team-impulse/Biscay_Blueeye/base_gui/basemap/map.png

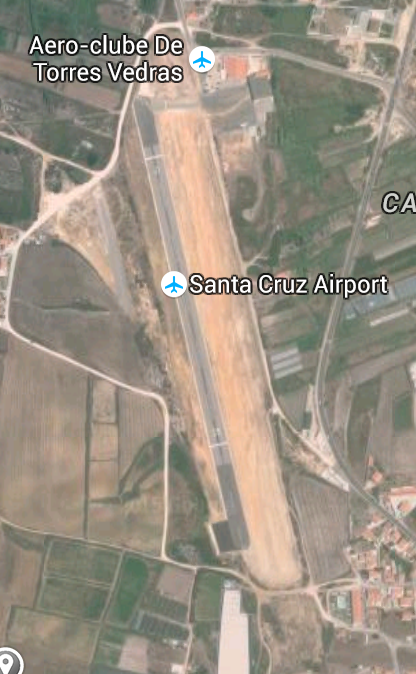
base_gui/basemap/map.png
