team-impulse/Biscay_Blueeye/base_gui/schema.rtf

CRC check (signal OK?) “True” or “False” (NO FURTHER DATA IF “False”)
RSSI (Received radio strength) (dB)
SNR (received radio signal-to-noise ratio) (dBm)
Air pressure (hPa)
External temperature (degC)
Internal (on-board) temperature (degC)
Relative Humidity (%)
Latitude (decimal degrees)
Longitude (decimal degrees)
HDOP (GPS precision, m)
Course (decimal degrees - please don’t convert to radians on the graph! It doesn’t make sense)
