team-impulse/Biscay_Blueeye/hardware/sensor-afe/sipm.kicad_pcb

## KiCad design hardware/sensor-afe/sipm.kicad_pcb (2015-10-05)

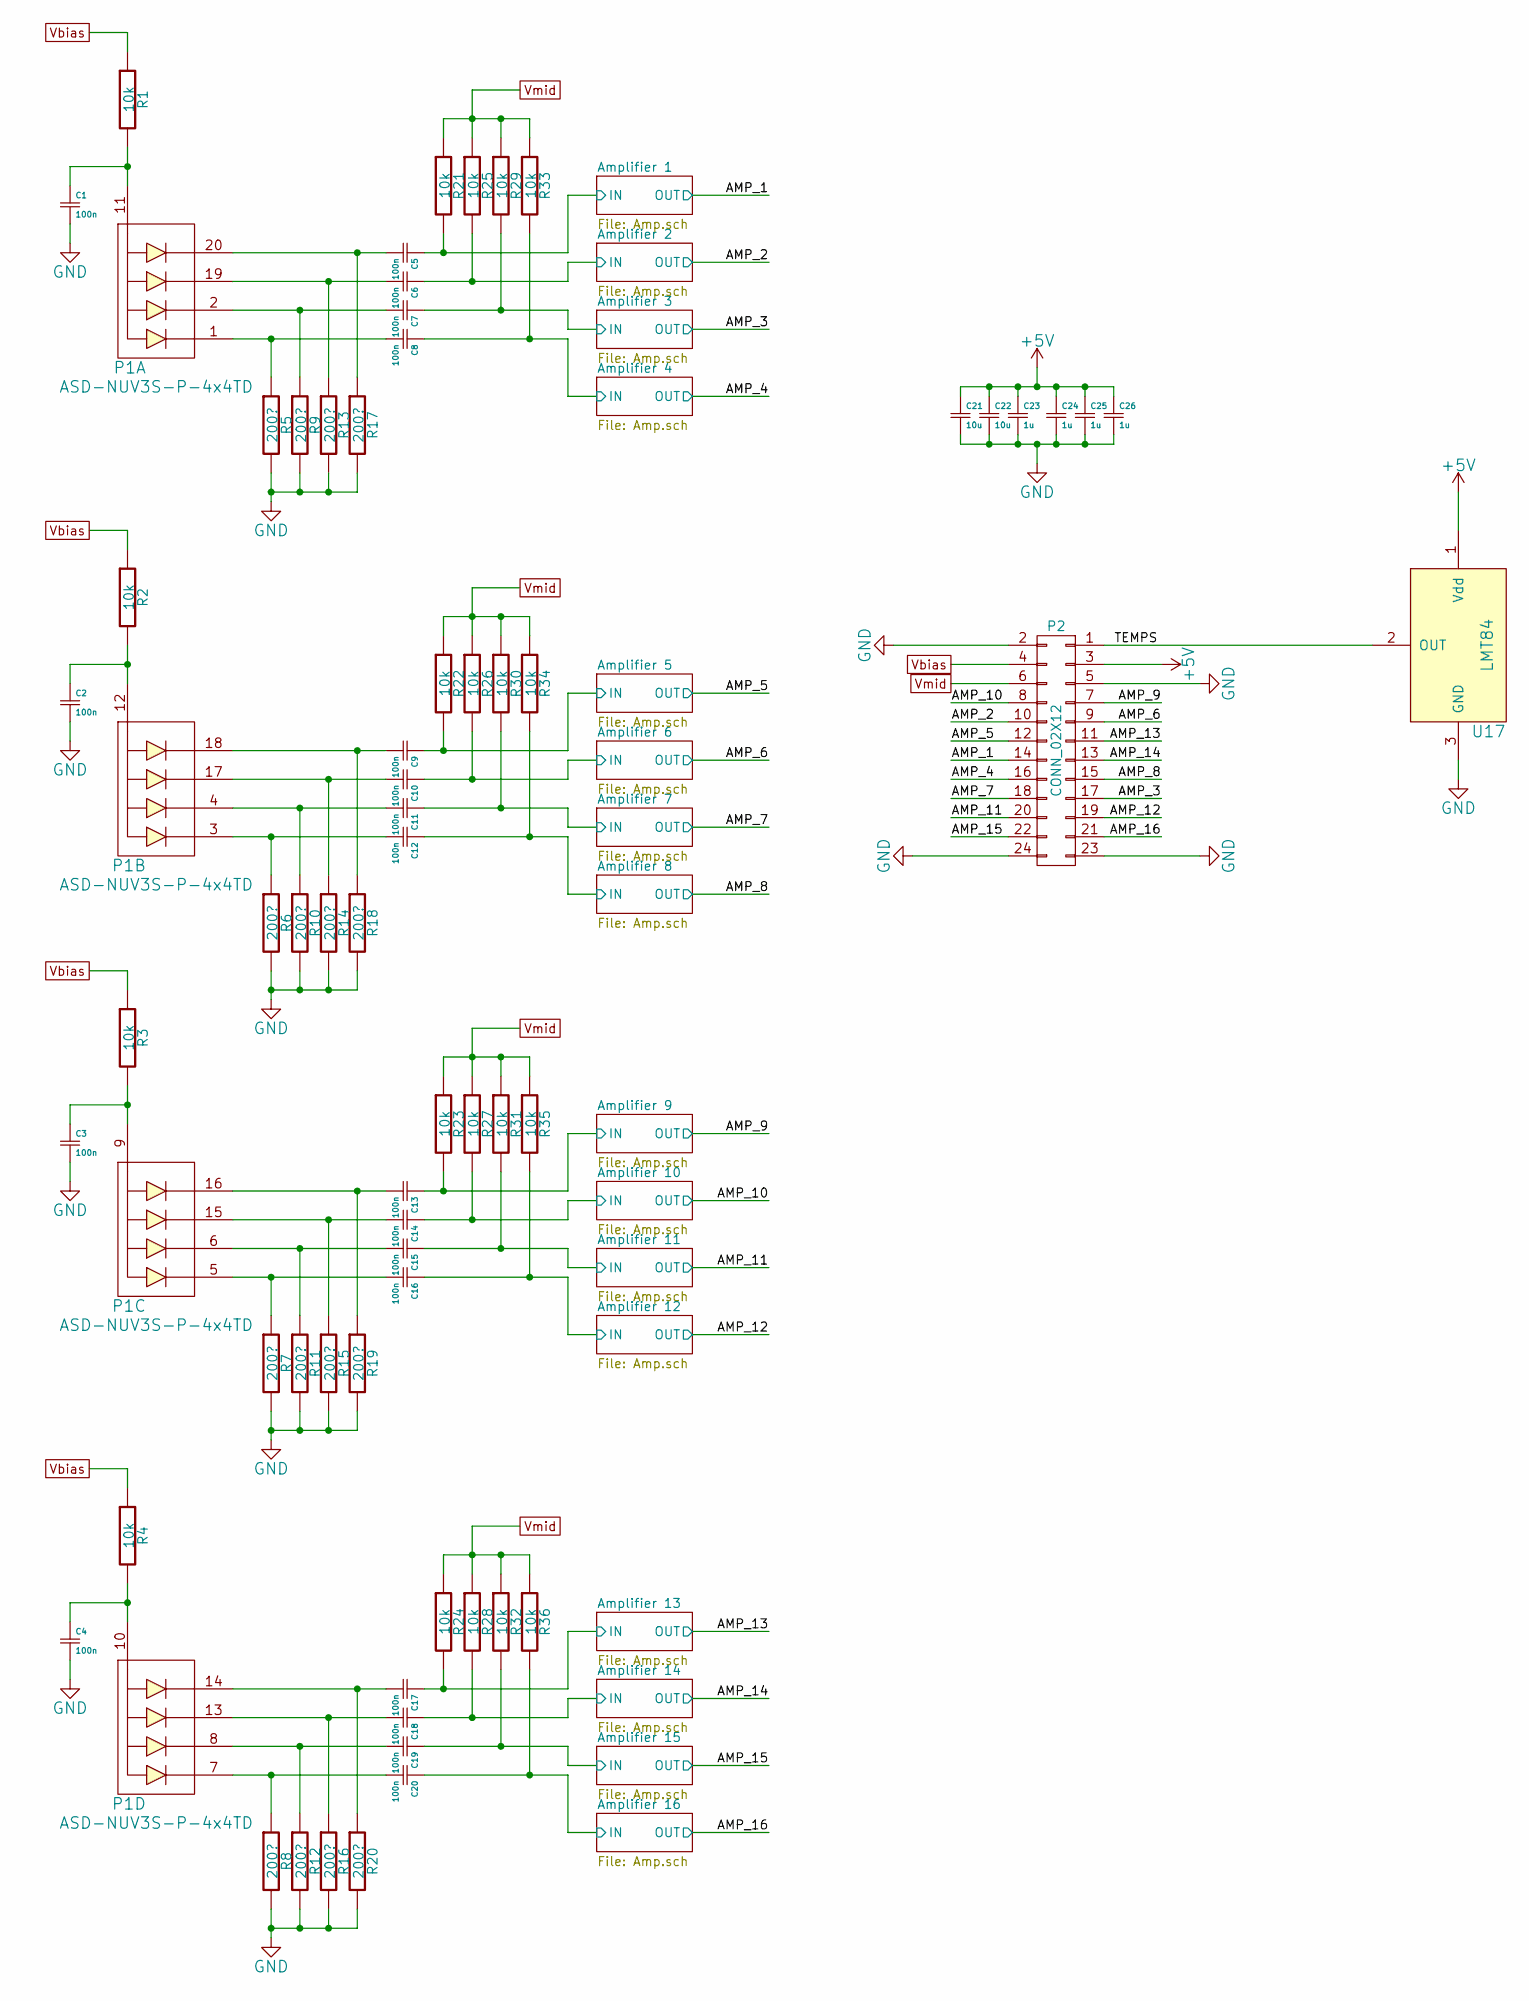
[picture p2: schematic sipm.sch]

Parts:
C1, C2, C3, C4, C5, C6, C7, C8, C9, C10, C11, C12, C13, C14, C15, C16, C17, C18, C19, C20: 100n
C21, C22: 10u
C23, C24, C25, C26: 1u
P1: ASD-NUV3S-P-4x4TD
P2: CONN_02X12
R1, R2, R3, R4, R21, R22, R23, R24, R25, R26, R27, R28, R29, R30, R31, R32, R33, R34, R35, R36: 10k
R5, R6, R7, R8, R9, R10, R11, R12, R13, R14, R15, R16, R17, R18, R19, R20: 200?
U17: LMT84

Connections:
+5V: C21.1, C22.1, C23.1, C24.1, C25.1, C26.1, P2.3, U17.1 (Vdd); also elsewhere on the board
/Amplifier 1/IN: C5.1, R21.2; also elsewhere on the board
/Amplifier 1/OUT: P2.14; also elsewhere on the board
/Amplifier 2/IN: C6.1, R25.2; also elsewhere on the board
/Amplifier 2/OUT: P2.10; also elsewhere on the board
/Amplifier 3/IN: C7.1, R29.2; also elsewhere on the board
/Amplifier 3/OUT: P2.17; also elsewhere on the board
/Amplifier 4/IN: C8.1, R33.2; also elsewhere on the board
/Amplifier 4/OUT: P2.16; also elsewhere on the board
/Amplifier 5/IN: C9.1, R22.2; also elsewhere on the board
/Amplifier 5/OUT: P2.12; also elsewhere on the board
/Amplifier 6/IN: C10.1, R26.2; also elsewhere on the board
/Amplifier 6/OUT: P2.9; also elsewhere on the board
/Amplifier 7/IN: C11.1, R30.2; also elsewhere on the board
/Amplifier 7/OUT: P2.18; also elsewhere on the board
/Amplifier 8/IN: C12.1, R34.2; also elsewhere on the board
/Amplifier 8/OUT: P2.15; also elsewhere on the board
/Amplifier 9/IN: C13.1, R23.2; also elsewhere on the board
/Amplifier 9/OUT: P2.7; also elsewhere on the board
/Amplifier 10/IN: C14.1, R27.2; also elsewhere on the board
/Amplifier 10/OUT: P2.8; also elsewhere on the board
/Amplifier 11/IN: C15.1, R31.2; also elsewhere on the board
/Amplifier 11/OUT: P2.20; also elsewhere on the board
/Amplifier 12/IN: C16.1, R35.2; also elsewhere on the board
/Amplifier 12/OUT: P2.19; also elsewhere on the board
/Amplifier 13/IN: C17.1, R24.2; also elsewhere on the board
/Amplifier 13/OUT: P2.11; also elsewhere on the board
/Amplifier 14/IN: C18.1, R28.2; also elsewhere on the board
/Amplifier 14/OUT: P2.13; also elsewhere on the board
/Amplifier 15/IN: C19.1, R32.2; also elsewhere on the board
/Amplifier 15/OUT: P2.22; also elsewhere on the board
/Amplifier 16/IN: C20.1, R36.2; also elsewhere on the board
/Amplifier 16/OUT: P2.21; also elsewhere on the board
/TEMPS: P2.1, U17.2 (OUT)
GND: C1.2, C2.2, C3.2, C4.2, C21.2, C22.2, C23.2, C24.2, C25.2, C26.2, P2.2, P2.5, P2.23, P2.24, R5.2, R6.2, R7.2, R8.2, R9.2, R10.2, R11.2, R12.2, R13.2, R14.2, R15.2, R16.2, R17.2, R18.2, R19.2, R20.2, U17.3 (GND); also elsewhere on the board
unnamed: C1.1, P1.11 (A1), R1.2
unnamed: C2.1, P1.12 (A2), R2.2
unnamed: C3.1, P1.9 (A3), R3.2
unnamed: C4.1, P1.10 (A4), R4.2
unnamed: C5.2, P1.20 (K1), R17.1
unnamed: C6.2, P1.19 (K2), R13.1
unnamed: C7.2, P1.2 (K3), R9.1
unnamed: C8.2, P1.1 (K4), R5.1
unnamed: C9.2, P1.18 (K5), R18.1
unnamed: C10.2, P1.17 (K6), R14.1
unnamed: C11.2, P1.4 (K7), R10.1
unnamed: C12.2, P1.3 (K8), R6.1
unnamed: C13.2, P1.16 (K9), R19.1
unnamed: C14.2, P1.15 (K10), R15.1
unnamed: C15.2, P1.6 (K11), R11.1
unnamed: C16.2, P1.5 (K12), R7.1
unnamed: C17.2, P1.14 (K13), R20.1
unnamed: C18.2, P1.13 (K14), R16.1
unnamed: C19.2, P1.8 (K15), R12.1
unnamed: C20.2, P1.7 (K16), R8.1
Vbias: P2.4, R1.1, R2.1, R3.1, R4.1
Vmid: P2.6, R21.1, R22.1, R23.1, R24.1, R25.1, R26.1, R27.1, R28.1, R29.1, R30.1, R31.1, R32.1, R33.1, R34.1, R35.1, R36.1; also elsewhere on the board

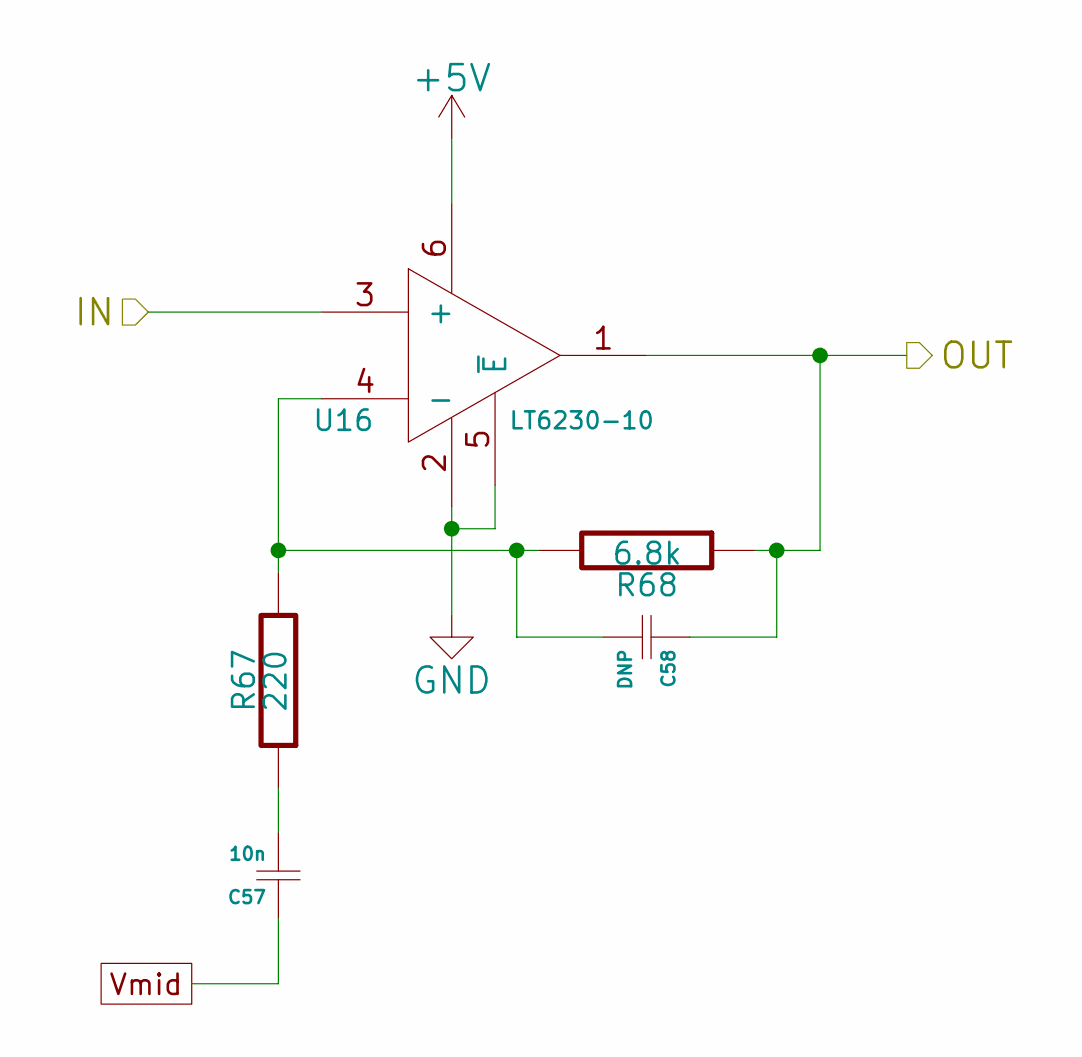
[picture p3: schematic Amp.sch]

Parts:
C35: 10n
C36: DNP
R45: 220
R46: 6.8k
U5: LT6230-10

Connections:
+5V: U5.6; also elsewhere on the board
/Amplifier 5/IN: U5.3 (+); also elsewhere on the board
/Amplifier 5/OUT: C36.1, R46.1, U5.1; also elsewhere on the board
GND: U5.2, U5.5 (~E); also elsewhere on the board
unnamed: C35.2, R45.1
unnamed: C36.2, R45.2, R46.2, U5.4 (-)
Vmid: C35.1; also elsewhere on the board

Parts of its further copies:
C27, C29, C31, C33, C37, C39, C41, C43, C45, C47, C49, C51, C53, C55, C57: 10n
C28, C30, C32, C34, C38, C40, C42, C44, C46, C48, C50, C52, C54, C56, C58: DNP
R37, R39, R41, R43, R47, R49, R51, R53, R55, R57, R59, R61, R63, R65, R67: 220
R38, R40, R42, R44, R48, R50, R52, R54, R56, R58, R60, R62, R64, R66, R68: 6.8k
U1, U2, U3, U4, U6, U7, U8, U9, U10, U11, U12, U13, U14, U15, U16: LT6230-10

Connections of its further copies:
+5V: U1.6, U2.6, U3.6, U4.6, U6.6, U7.6, U8.6, U9.6, U10.6, U11.6, U12.6, U13.6, U14.6, U15.6, U16.6; also elsewhere on the board
/Amplifier 1/IN: U1.3 (+); also elsewhere on the board
/Amplifier 1/OUT: C28.1, R38.1, U1.1; also elsewhere on the board
/Amplifier 2/IN: U2.3 (+); also elsewhere on the board
/Amplifier 2/OUT: C30.1, R40.1, U2.1; also elsewhere on the board
/Amplifier 3/IN: U3.3 (+); also elsewhere on the board
/Amplifier 3/OUT: C32.1, R42.1, U3.1; also elsewhere on the board
/Amplifier 4/IN: U4.3 (+); also elsewhere on the board
/Amplifier 4/OUT: C34.1, R44.1, U4.1; also elsewhere on the board
/Amplifier 6/IN: U6.3 (+); also elsewhere on the board
/Amplifier 6/OUT: C38.1, R48.1, U6.1; also elsewhere on the board
/Amplifier 7/IN: U7.3 (+); also elsewhere on the board
/Amplifier 7/OUT: C40.1, R50.1, U7.1; also elsewhere on the board
/Amplifier 8/IN: U8.3 (+); also elsewhere on the board
/Amplifier 8/OUT: C42.1, R52.1, U8.1; also elsewhere on the board
/Amplifier 9/IN: U9.3 (+); also elsewhere on the board
/Amplifier 9/OUT: C44.1, R54.1, U9.1; also elsewhere on the board
/Amplifier 10/IN: U10.3 (+); also elsewhere on the board
/Amplifier 10/OUT: C46.1, R56.1, U10.1; also elsewhere on the board
/Amplifier 11/IN: U11.3 (+); also elsewhere on the board
/Amplifier 11/OUT: C48.1, R58.1, U11.1; also elsewhere on the board
/Amplifier 12/IN: U12.3 (+); also elsewhere on the board
/Amplifier 12/OUT: C50.1, R60.1, U12.1; also elsewhere on the board
/Amplifier 13/IN: U13.3 (+); also elsewhere on the board
/Amplifier 13/OUT: C52.1, R62.1, U13.1; also elsewhere on the board
/Amplifier 14/IN: U14.3 (+); also elsewhere on the board
/Amplifier 14/OUT: C54.1, R64.1, U14.1; also elsewhere on the board
/Amplifier 15/IN: U15.3 (+); also elsewhere on the board
/Amplifier 15/OUT: C56.1, R66.1, U15.1; also elsewhere on the board
/Amplifier 16/IN: U16.3 (+); also elsewhere on the board
/Amplifier 16/OUT: C58.1, R68.1, U16.1; also elsewhere on the board
GND: U1.2, U1.5 (~E), U2.2, U2.5 (~E), U3.2, U3.5 (~E), U4.2, U4.5 (~E), U6.2, U6.5 (~E), U7.2, U7.5 (~E), U8.2, U8.5 (~E), U9.2, U9.5 (~E), U10.2, U10.5 (~E), U11.2, U11.5 (~E), U12.2, U12.5 (~E), U13.2, U13.5 (~E), U14.2, U14.5 (~E), U15.2, U15.5 (~E), U16.2, U16.5 (~E); also elsewhere on the board
unnamed: C27.2, R37.1
unnamed: C28.2, R37.2, R38.2, U1.4 (-)
unnamed: C29.2, R39.1
unnamed: C30.2, R39.2, R40.2, U2.4 (-)
unnamed: C31.2, R41.1
unnamed: C32.2, R41.2, R42.2, U3.4 (-)
unnamed: C33.2, R43.1
unnamed: C34.2, R43.2, R44.2, U4.4 (-)
unnamed: C37.2, R47.1
unnamed: C38.2, R47.2, R48.2, U6.4 (-)
unnamed: C39.2, R49.1
unnamed: C40.2, R49.2, R50.2, U7.4 (-)
unnamed: C41.2, R51.1
unnamed: C42.2, R51.2, R52.2, U8.4 (-)
unnamed: C43.2, R53.1
unnamed: C44.2, R53.2, R54.2, U9.4 (-)
unnamed: C45.2, R55.1
unnamed: C46.2, R55.2, R56.2, U10.4 (-)
unnamed: C47.2, R57.1
unnamed: C48.2, R57.2, R58.2, U11.4 (-)
unnamed: C49.2, R59.1
unnamed: C50.2, R59.2, R60.2, U12.4 (-)
unnamed: C51.2, R61.1
unnamed: C52.2, R61.2, R62.2, U13.4 (-)
unnamed: C53.2, R63.1
unnamed: C54.2, R63.2, R64.2, U14.4 (-)
unnamed: C55.2, R65.1
unnamed: C56.2, R65.2, R66.2, U15.4 (-)
unnamed: C57.2, R67.1
unnamed: C58.2, R67.2, R68.2, U16.4 (-)
Vmid: C27.1, C29.1, C31.1, C33.1, C37.1, C39.1, C41.1, C43.1, C45.1, C47.1, C49.1, C51.1, C53.1, C55.1, C57.1; also elsewhere on the board

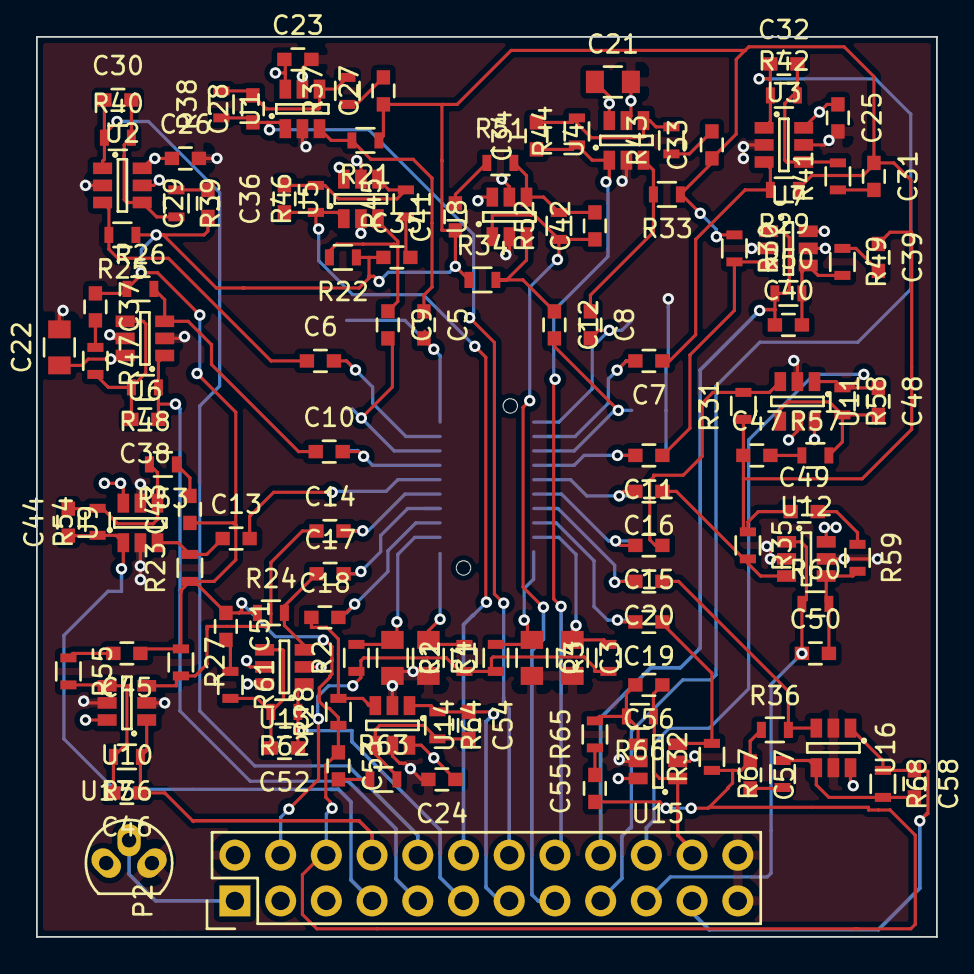
[picture p4: board sipm.kicad_pcb from above]

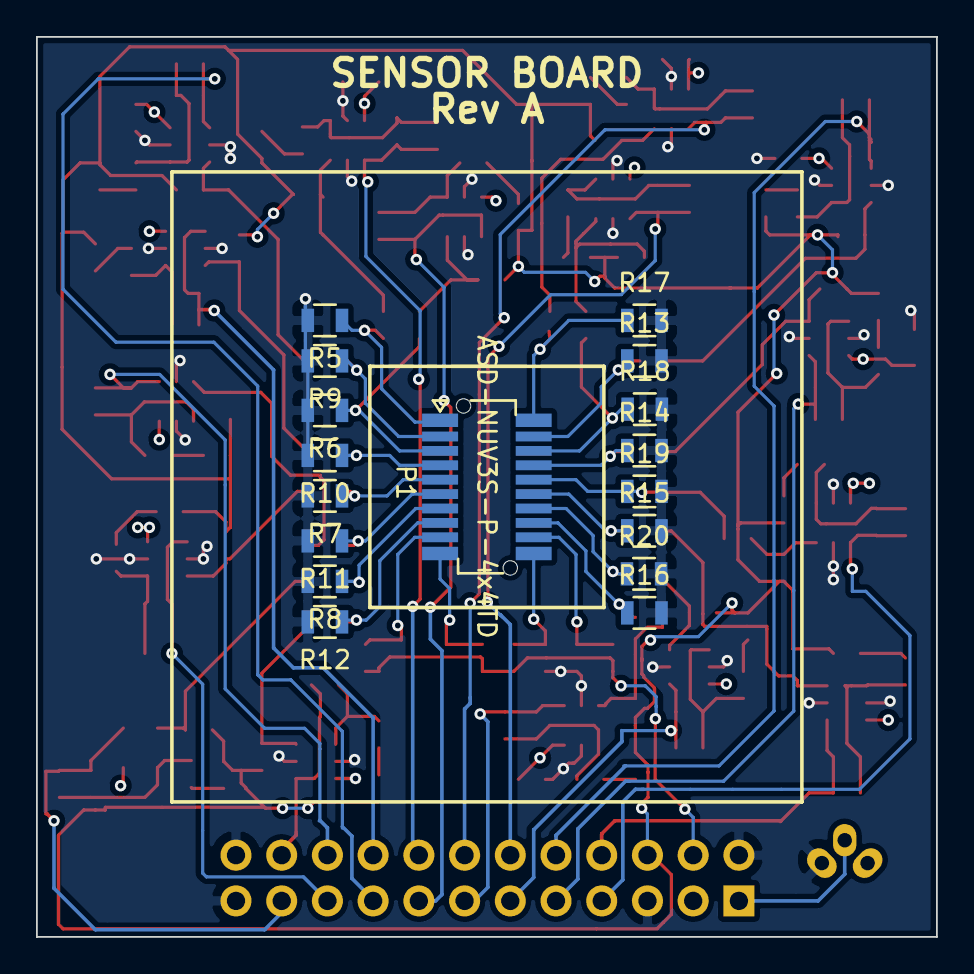
[picture p5: board sipm.kicad_pcb from below]

Board: 4 copper layers, 50.0 x 50.0 mm, 145 parts (17 on the bottom side), 89 nets.
