team-impulse/Biscay_Blueeye/hardware/fpga/sipm-fpga.kicad_pcb

## KiCad design hardware/fpga/sipm-fpga.kicad_pcb (2015-10-05)

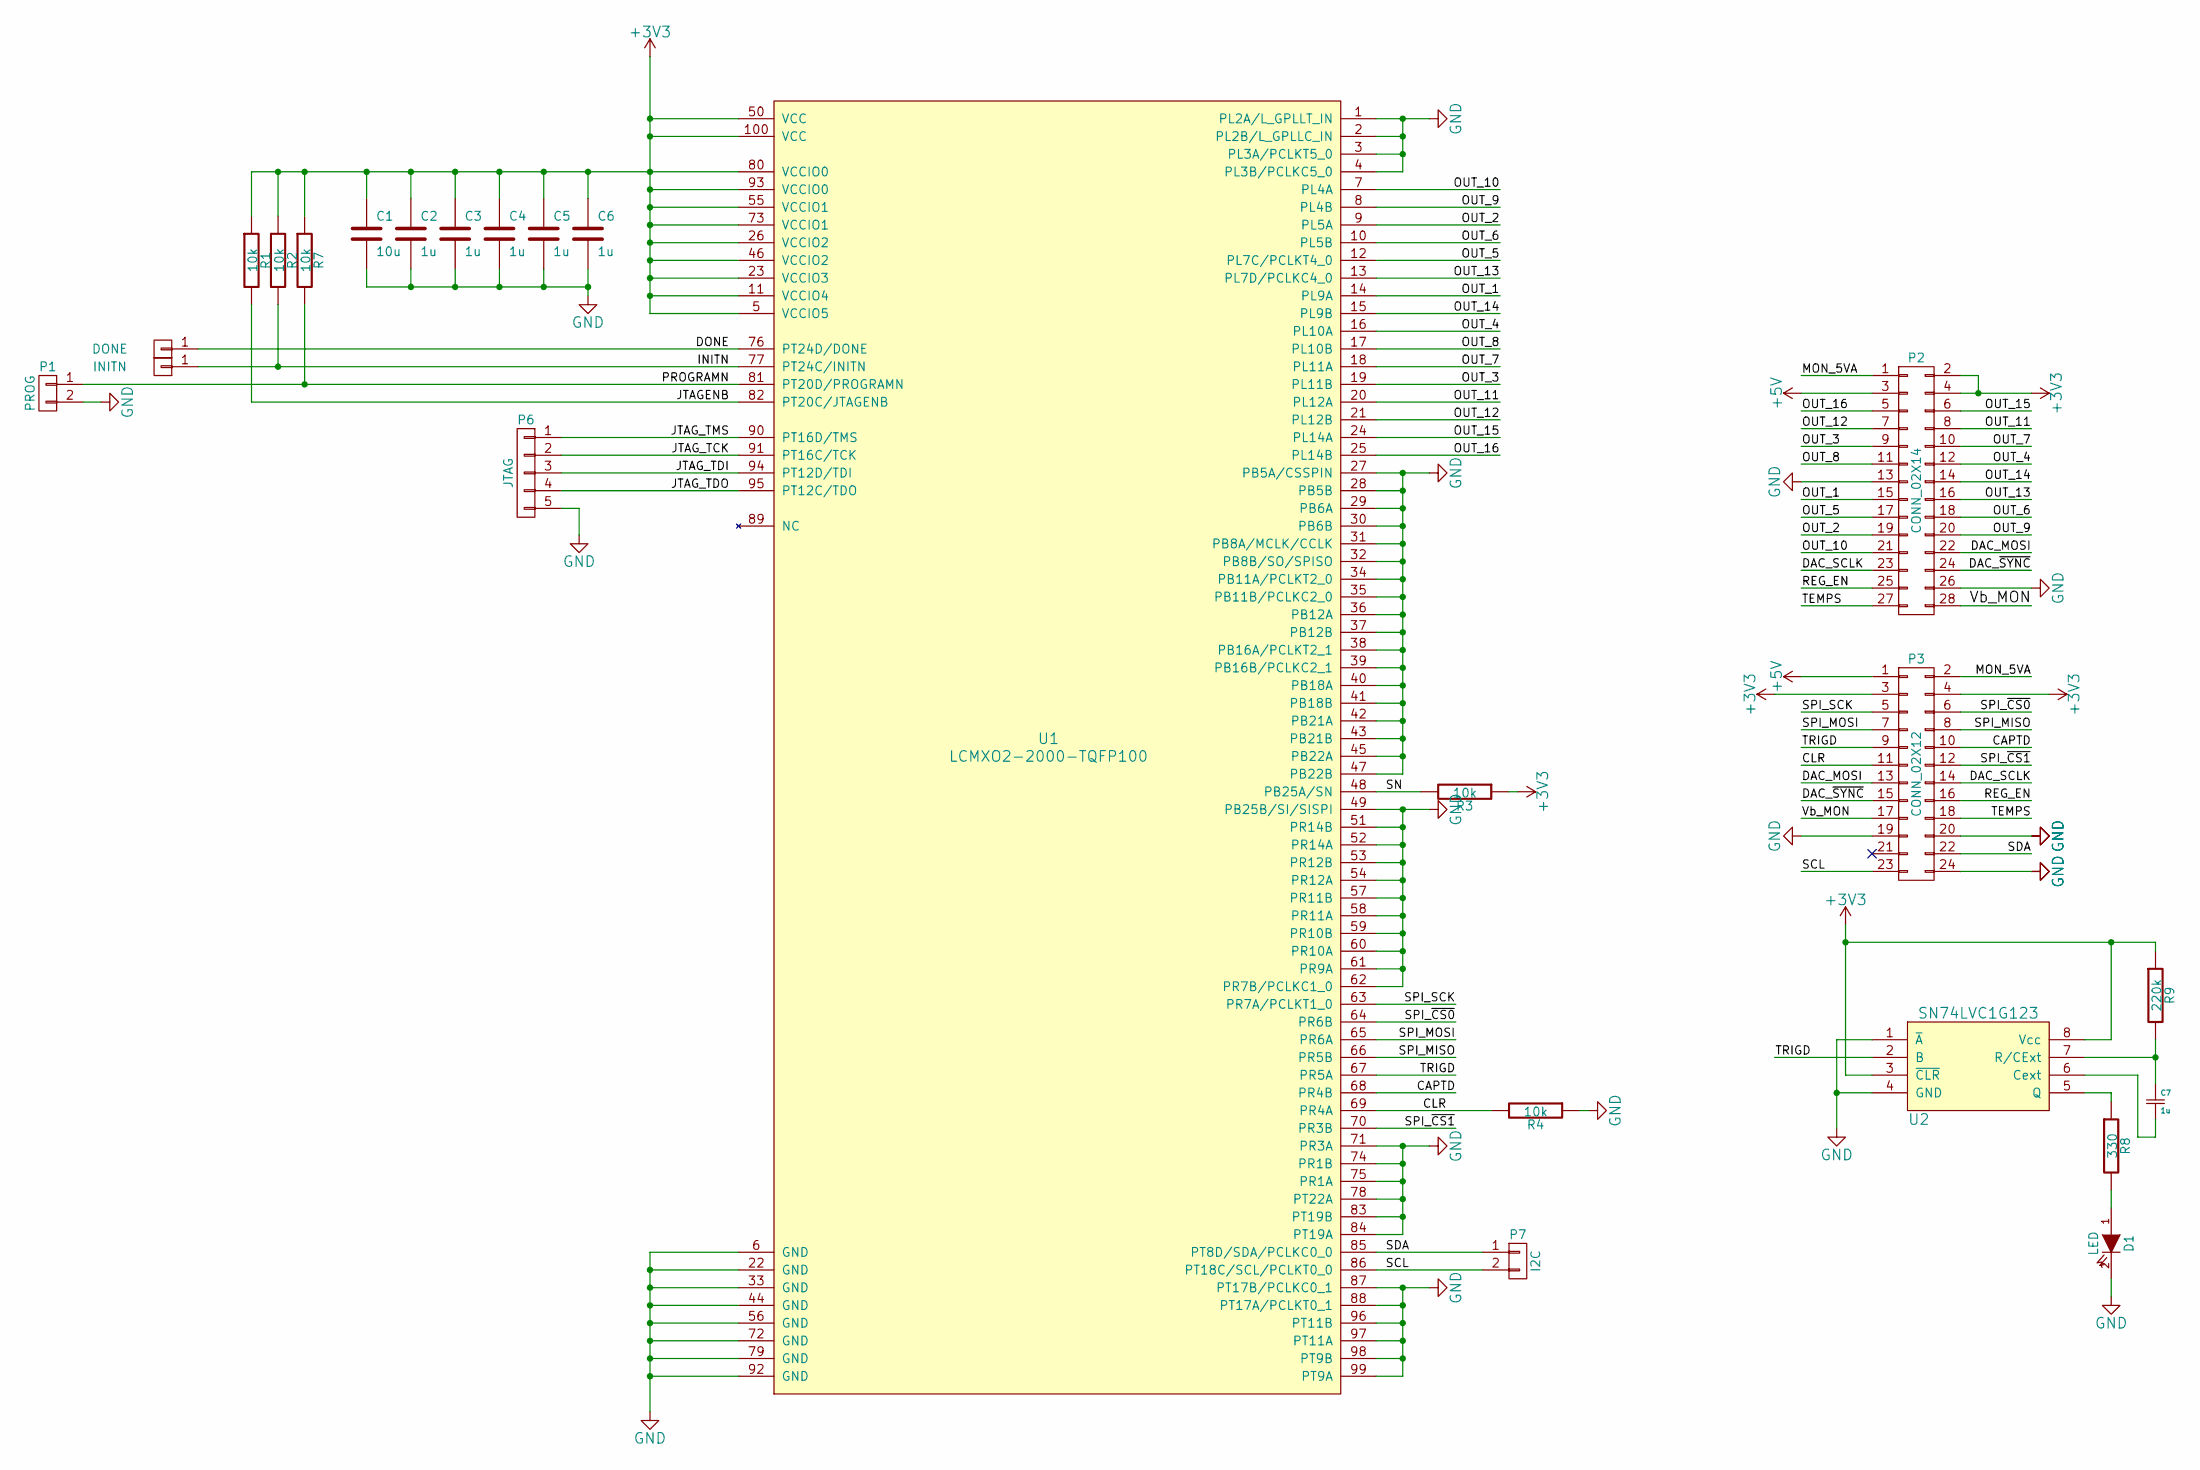
[picture p6: schematic sipm-fpga.sch]

Parts:
C1: 10u
C2, C3, C4, C5, C6, C7: 1u
D1: LED
P1: PROG
P2: CONN_02X14
P3: CONN_02X12
P4: DONE
P5: INITN
P6: JTAG
P7: I2C
R1, R2, R3, R4, R7: 10k
R8: 330
R9: 220k
U1: LCMXO2-2000-TQFP100
U2: SN74LVC1G123

Connections:
+3V3: C1.1, C2.1, C3.1, C4.1, C5.1, C6.1, P2.2, P2.4, P3.3, P3.4, R1.1, R2.1, R3.1, R7.1, R9.1, U1.5 (VCCIO5), U1.11 (VCCIO4), U1.23 (VCCIO3), U1.26 (VCCIO2), U1.46 (VCCIO2), U1.50 (VCC), U1.55 (VCCIO1), U1.73 (VCCIO1), U1.80 (VCCIO0), U1.93 (VCCIO0), U1.100 (VCC), U2.3 (~CLR), U2.8 (Vcc)
+5V: P2.3, P3.1
/CAPTD: P3.10, U1.68 (PR4B)
/CLR: P3.11, R4.2, U1.69 (PR4A)
/DAC_MOSI: P2.22, P3.13
/DAC_SCLK: P2.23, P3.14
/DAC_~SYNC: P2.24, P3.15
/DONE: P4.1, U1.76 (PT24D/DONE)
/INITN: P5.1, R2.2, U1.77 (PT24C/INITN)
/JTAGENB: R1.2, U1.82 (PT20C/JTAGENB)
/JTAG_TCK: P6.2, U1.91 (PT16C/TCK)
/JTAG_TDI: P6.3, U1.94 (PT12D/TDI)
/JTAG_TDO: P6.4, U1.95 (PT12C/TDO)
/JTAG_TMS: P6.1, U1.90 (PT16D/TMS)
/MON_5VA: P2.1, P3.2
/OUT_1: P2.15, U1.14 (PL9A)
/OUT_2: P2.19, U1.9 (PL5A)
/OUT_3: P2.9, U1.19 (PL11B)
/OUT_4: P2.12, U1.16 (PL10A)
/OUT_5: P2.17, U1.12 (PL7C/PCLKT4_0)
/OUT_6: P2.18, U1.10 (PL5B)
/OUT_7: P2.10, U1.18 (PL11A)
/OUT_8: P2.11, U1.17 (PL10B)
/OUT_9: P2.20, U1.8 (PL4B)
/OUT_10: P2.21, U1.7 (PL4A)
/OUT_11: P2.8, U1.20 (PL12A)
/OUT_12: P2.7, U1.21 (PL12B)
/OUT_13: P2.16, U1.13 (PL7D/PCLKC4_0)
/OUT_14: P2.14, U1.15 (PL9B)
/OUT_15: P2.6, U1.24 (PL14A)
/OUT_16: P2.5, U1.25 (PL14B)
/PROGRAMN: P1.1, R7.2, U1.81 (PT20D/PROGRAMN)
/REG_EN: P2.25, P3.16
/SCL: P3.23, P7.2, U1.86 (PT18C/SCL/PCLKT0_0)
/SDA: P3.22, P7.1, U1.85 (PT8D/SDA/PCLKC0_0)
/SN: R3.2, U1.48 (PB25A/SN)
/SPI_MISO: P3.8, U1.66 (PR5B)
/SPI_MOSI: P3.7, U1.65 (PR6A)
/SPI_SCK: P3.5, U1.63 (PR7A/PCLKT1_0)
/SPI_~CS0: P3.6, U1.64 (PR6B)
/SPI_~CS1: P3.12, U1.70 (PR3B)
/TEMPS: P2.27, P3.18
/TRIGD: P3.9, U1.67 (PR5A), U2.2 (B)
/Vb_MON: P2.28, P3.17
GND: C1.2, C2.2, C3.2, C4.2, C5.2, C6.2, D1.2 (K), P1.2, P2.13, P2.26, P3.19, P3.20, P3.24, P6.5, R4.1, U1.1 (PL2A/L_GPLLT_IN), U1.2 (PL2B/L_GPLLC_IN), U1.3 (PL3A/PCLKT5_0), U1.4 (PL3B/PCLKC5_0), U1.6 (GND), U1.22 (GND), U1.27 (PB5A/CSSPIN), U1.28 (PB5B), U1.29 (PB6A), U1.30 (PB6B), U1.31 (PB8A/MCLK/CCLK), U1.32 (PB8B/SO/SPISO), U1.33 (GND), U1.34 (PB11A/PCLKT2_0), U1.35 (PB11B/PCLKC2_0), U1.36 (PB12A), U1.37 (PB12B), U1.38 (PB16A/PCLKT2_1), U1.39 (PB16B/PCLKC2_1), U1.40 (PB18A), U1.41 (PB18B), U1.42 (PB21A), U1.43 (PB21B), U1.44 (GND), U1.45 (PB22A), U1.47 (PB22B), U1.49 (PB25B/SI/SISPI), U1.51 (PR14B), U1.52 (PR14A), U1.53 (PR12B), U1.54 (PR12A), U1.56 (GND), U1.57 (PR11B), U1.58 (PR11A), U1.59 (PR10B), U1.60 (PR10A), U1.61 (PR9A), U1.62 (PR7B/PCLKC1_0), U1.71 (PR3A), U1.72 (GND), U1.74 (PR1B), U1.75 (PR1A), U1.78 (PT22A), U1.79 (GND), U1.83 (PT19B), U1.84 (PT19A), U1.87 (PT17B/PCLKC0_1), U1.88 (PT17A/PCLKT0_1), U1.92 (GND), U1.96 (PT11B), U1.97 (PT11A), U1.98 (PT9B), U1.99 (PT9A), U2.1 (~A), U2.4 (GND)
unnamed: C7.1, R9.2, U2.7 (R/CExt)
unnamed: C7.2, U2.6 (Cext)
unnamed: D1.1 (A), R8.2
unnamed: R8.1, U2.5 (Q)

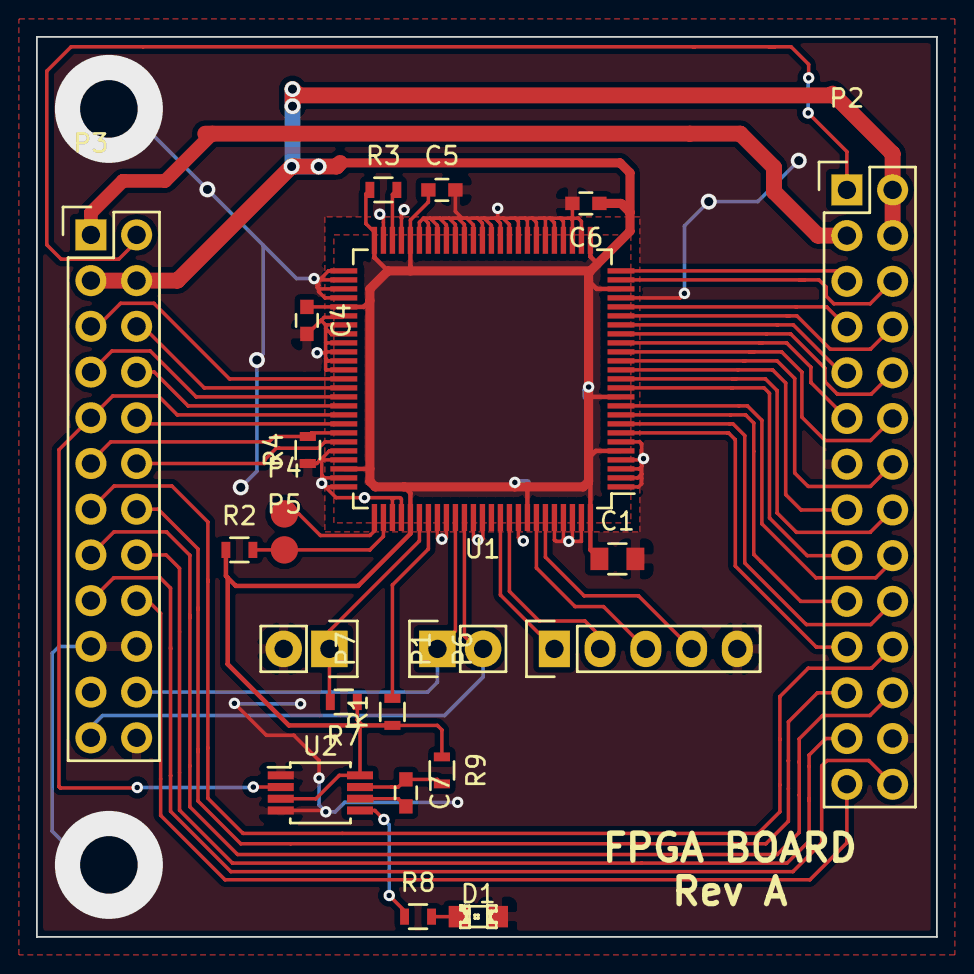
[picture p7: board sipm-fpga.kicad_pcb from above]

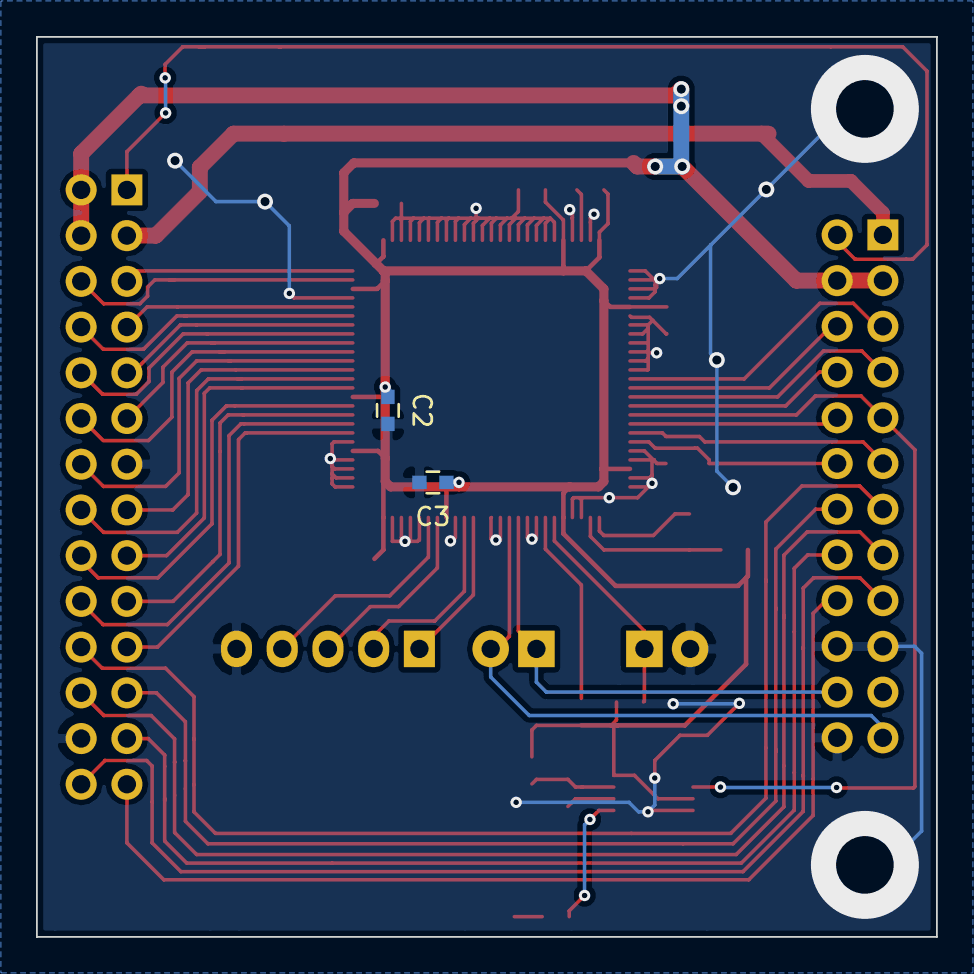
[picture p8: board sipm-fpga.kicad_pcb from below]

Board: 2 copper layers, 50.0 x 50.0 mm, 24 parts (2 on the bottom side), 49 nets.
