team-impulse/Biscay_Blueeye/hardware/power/mcu.kicad_pcb

## KiCad design hardware/power/mcu.kicad_pcb (2015-10-05)

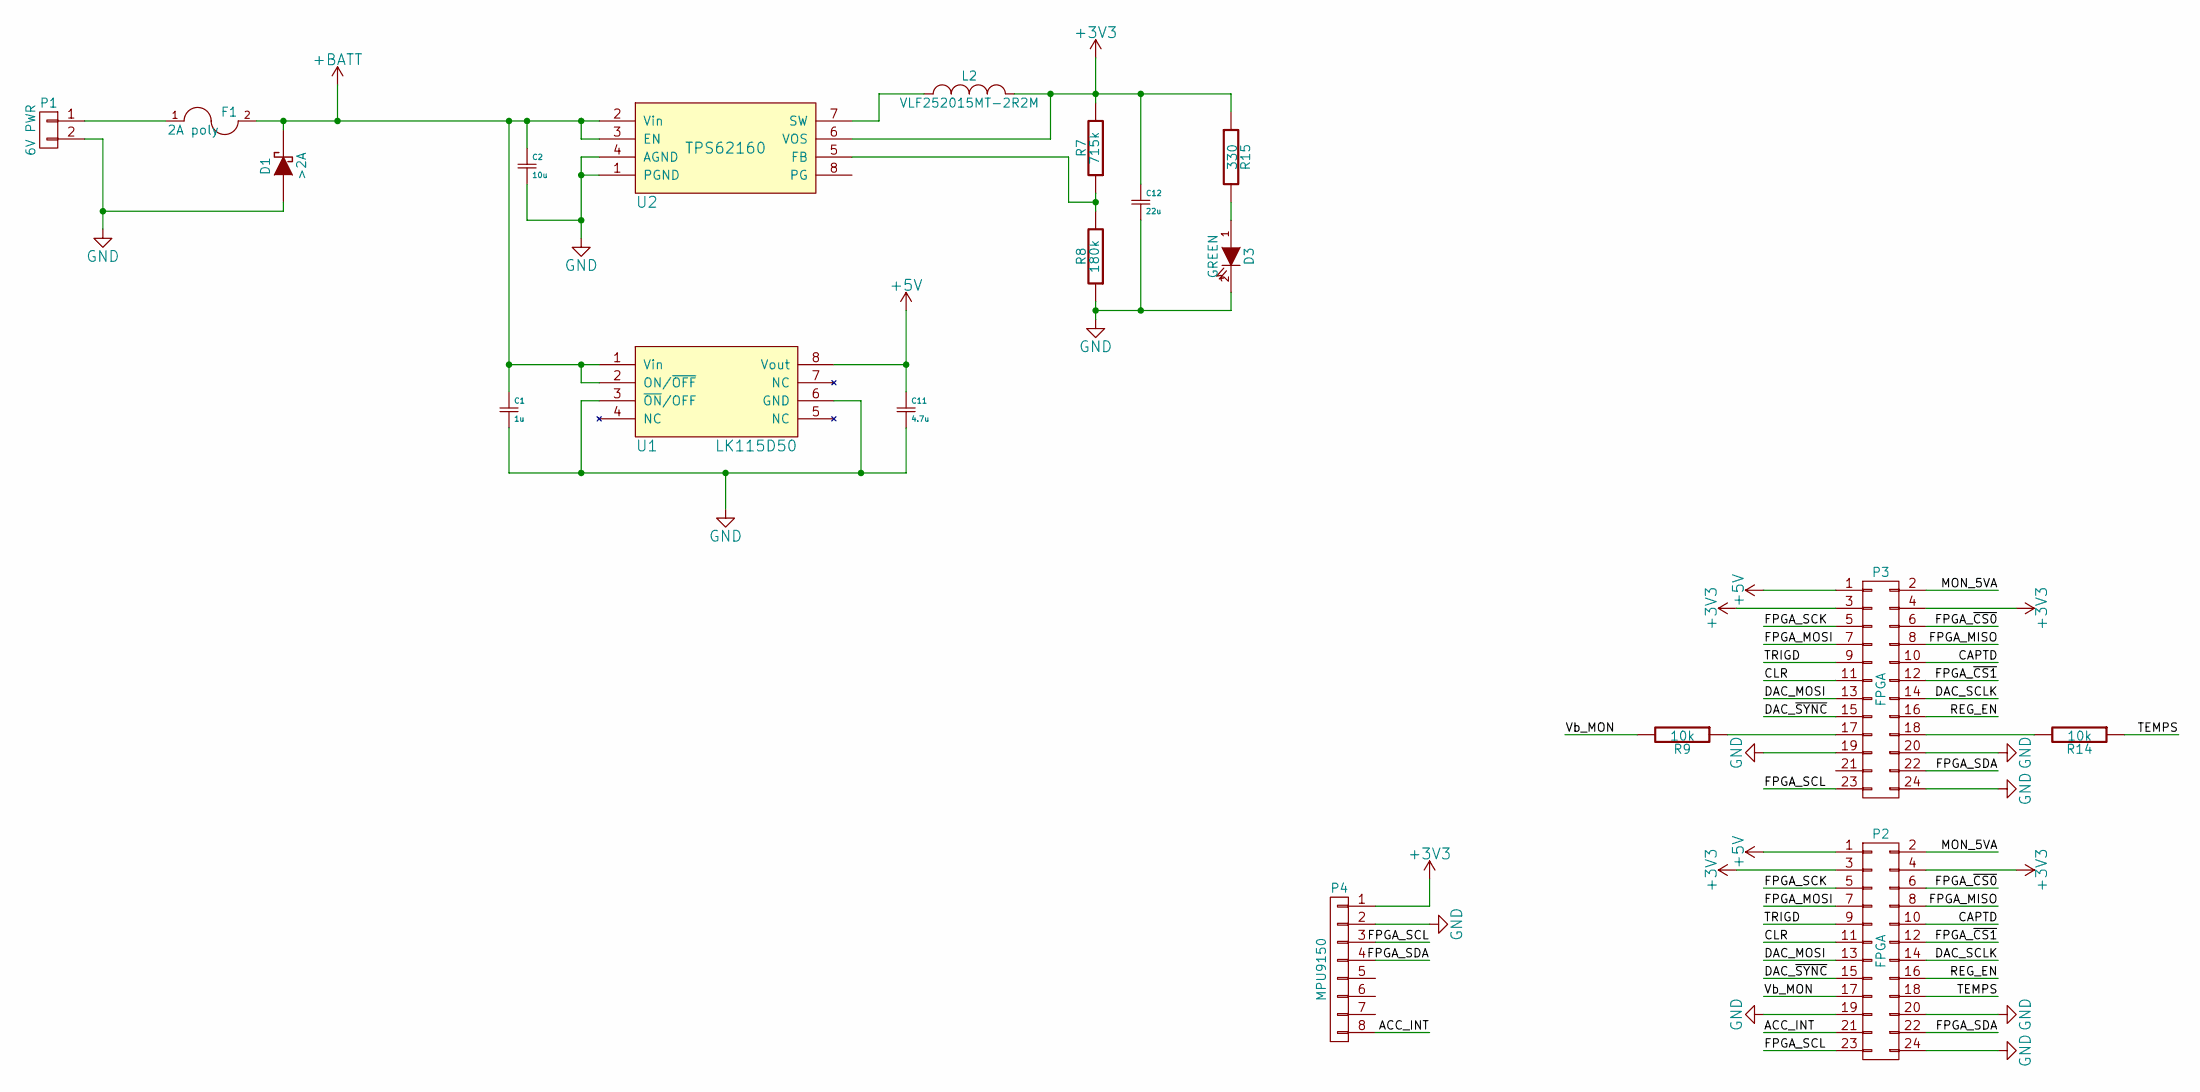
[picture p9: schematic mcu.sch]

Parts:
C1: 1u
C2: 10u
C11: 4.7u
C12: 22u
D1: >2A
D3: GREEN
F1: 2A poly
L2: VLF252015MT-2R2M
P1: 6V PWR
P2, P3: FPGA
P4: MPU9150
R7: 715k
R8: 180k
R9, R14: 10k
R15: 330
U1: LK115D50
U2: TPS62160

Connections:
+3V3: C12.1, L2.2, P2.3, P2.4, P3.3, P3.4, P4.1, R7.2, R15.1, U2.6 (VOS)
+5V: C11.1, P2.1, P3.1, U1.8 (Vout)
+BATT: C1.1, C2.1, D1.2 (K), F1.2, U1.1 (Vin), U1.2 (ON/~OFF), U2.2 (Vin), U2.3 (EN)
/ACC_INT: P2.21, P4.8
/CAPTD: P2.10, P3.10
/CLR: P2.11, P3.11
/DAC_MOSI: P2.13, P3.13
/DAC_SCLK: P2.14, P3.14
/DAC_~SYNC: P2.15, P3.15
/FPGA_MISO: P2.8, P3.8
/FPGA_MOSI: P2.7, P3.7
/FPGA_SCK: P2.5, P3.5
/FPGA_SCL: P2.23, P3.23, P4.3
/FPGA_SDA: P2.22, P3.22, P4.4
/FPGA_~CS0: P2.6, P3.6
/FPGA_~CS1: P2.12, P3.12
/MON_5VA: P2.2, P3.2
/REG_EN: P2.16, P3.16
/TEMPS: P2.18, R14.1
/TRIGD: P2.9, P3.9
/Vb_MON: P2.17, R9.2
GND: C1.2, C2.2, C11.2, C12.2, D1.1 (A), D3.2 (K), P1.2, P2.19, P2.20, P2.24, P3.19, P3.20, P3.24, P4.2, R8.1, U1.3 (~ON~/OFF), U1.6 (GND), U2.1 (PGND), U2.4 (AGND)
unnamed: D3.1 (A), R15.2
unnamed: F1.1, P1.1
unnamed: L2.1, U2.7 (SW)
unnamed: P3.17, R9.1
unnamed: P3.18, R14.2
unnamed: R7.1, R8.2, U2.5 (FB)

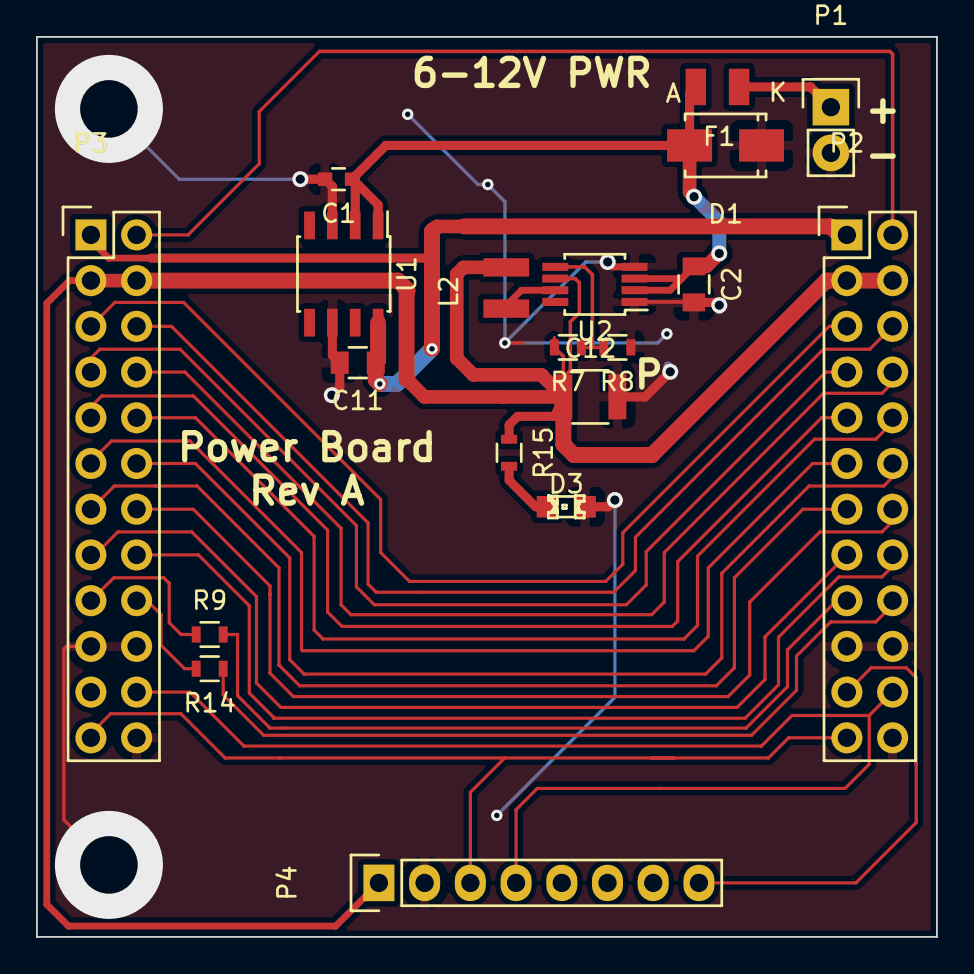
[picture p10: board mcu.kicad_pcb from above]

Board: 2 copper layers, 50.0 x 50.0 mm, 19 parts (0 on the bottom side), 28 nets.
