team-impulse/Biscay_Blueeye/hardware/comparator/sipm-comp.kicad_pcb

## KiCad design hardware/comparator/sipm-comp.kicad_pcb (2015-10-05)

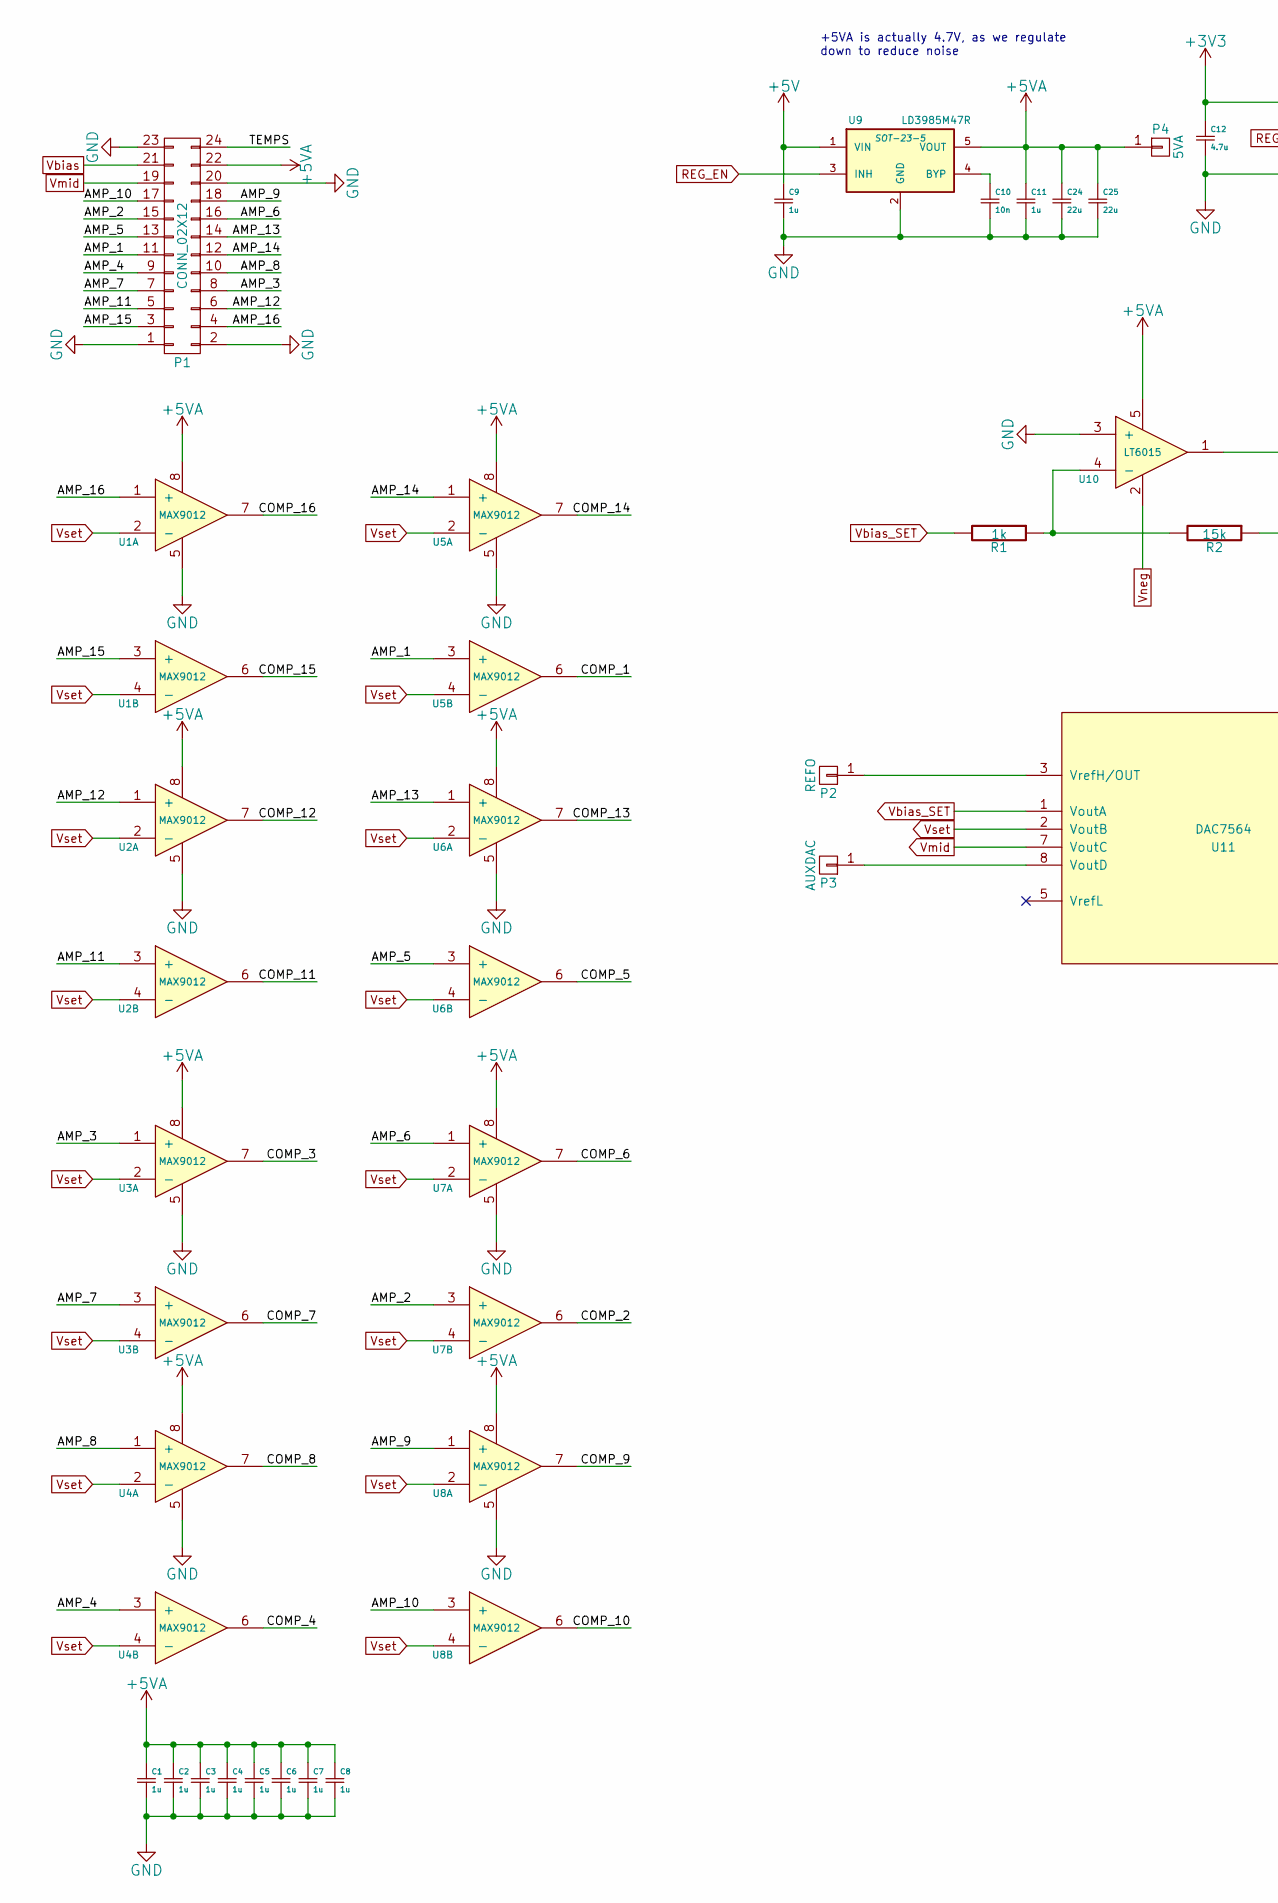
[picture p11: schematic sipm-comp.sch, part in row 1, column 1]

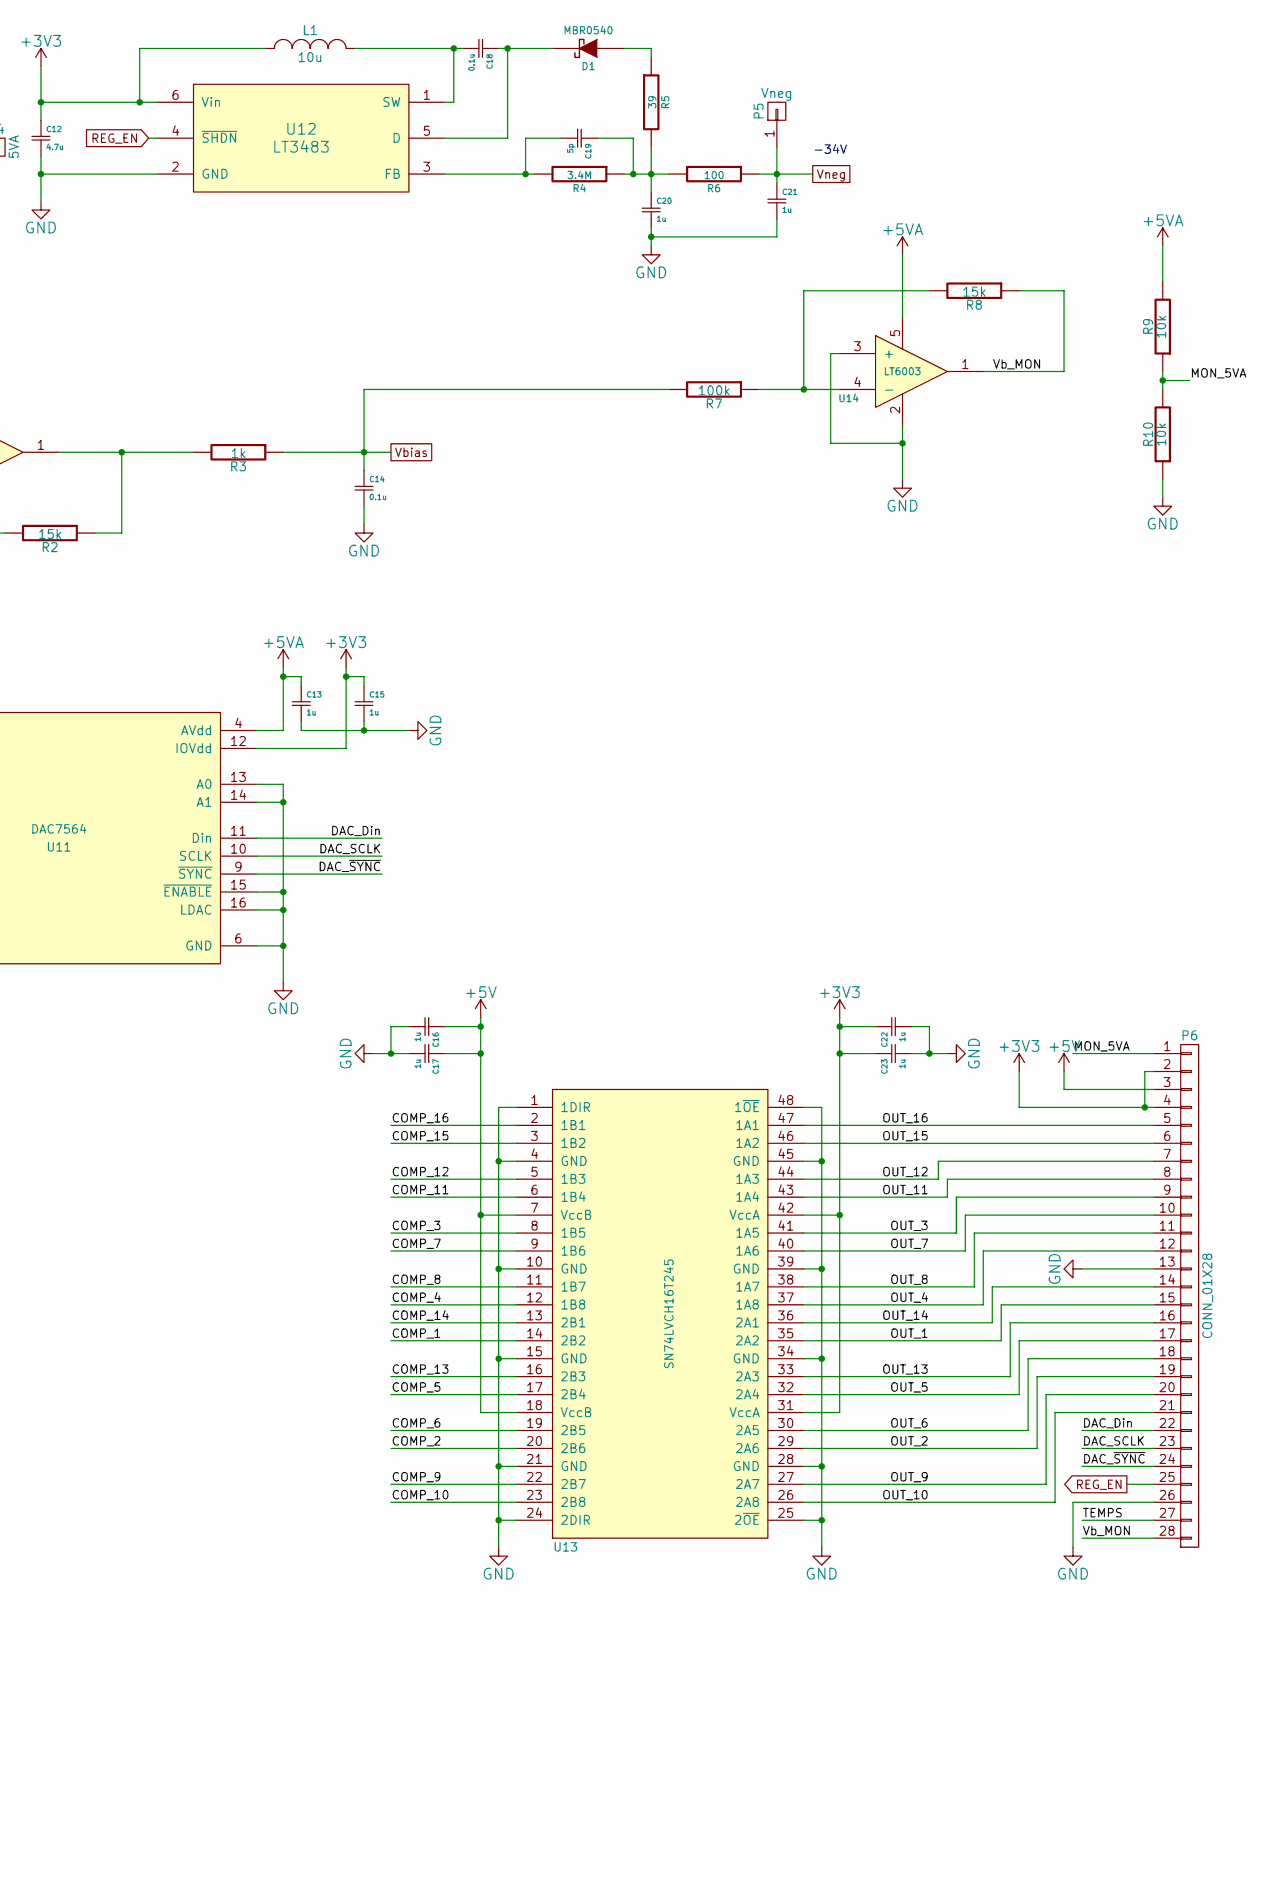
[picture p12: schematic sipm-comp.sch, part in row 1, column 2]

Parts:
C1, C2, C3, C4, C5, C6, C7, C8, C9, C11, C13, C15, C16, C17, C20, C21, C22, C23: 1u
C10: 10n
C12: 4.7u
C14, C18: 0.1u
C19: 5p
C24, C25: 22u
D1: MBR0540
L1: 10u
P1: CONN_02X12
P2: REFO
P3: AUXDAC
P4: 5VA
P5: Vneg
P6: CONN_01X28
R1, R3: 1k
R2, R8: 15k
R4: 3.4M
R5: 39
R6: 100
R7: 100k
R9, R10: 10k
U1, U2, U3, U4, U5, U6, U7, U8: MAX9012
U9: LD3985M47R; SOT-23-5
U10: LT6015
U11: DAC7564
U12: LT3483
U13: SN74LVCH16T245
U14: LT6003

Connections:
+3V3: C12.1, C15.1, C22.1, C23.1, L1.1, P6.2, P6.4, U11.12 (IOVdd), U12.6 (Vin), U13.31 (VccA), U13.42 (VccA)
+5V: C9.1, C16.1, C17.1, P6.3, U9.1 (VIN), U13.7 (VccB), U13.18 (VccB)
+5VA: C1.1, C2.1, C3.1, C4.1, C5.1, C6.1, C7.1, C8.1, C11.1, C13.1, C24.1, C25.1, P1.22, P4.1, R9.2, U1.8, U2.8, U3.8, U4.8, U5.8, U6.8, U7.8, U8.8, U9.5 (VOUT), U10.5, U11.4 (AVdd), U14.5
/AMP_1: P1.11, U5.3 (+)
/AMP_2: P1.15, U7.3 (+)
/AMP_3: P1.8, U3.1 (+)
/AMP_4: P1.9, U4.3 (+)
/AMP_5: P1.13, U6.3 (+)
/AMP_6: P1.16, U7.1 (+)
/AMP_7: P1.7, U3.3 (+)
/AMP_8: P1.10, U4.1 (+)
/AMP_9: P1.18, U8.1 (+)
/AMP_10: P1.17, U8.3 (+)
/AMP_11: P1.5, U2.3 (+)
/AMP_12: P1.6, U2.1 (+)
/AMP_13: P1.14, U6.1 (+)
/AMP_14: P1.12, U5.1 (+)
/AMP_15: P1.3, U1.3 (+)
/AMP_16: P1.4, U1.1 (+)
/COMP_1: U5.6, U13.14 (2B2)
/COMP_2: U7.6, U13.20 (2B6)
/COMP_3: U3.7, U13.8 (1B5)
/COMP_4: U4.6, U13.12 (1B8)
/COMP_5: U6.6, U13.17 (2B4)
/COMP_6: U7.7, U13.19 (2B5)
/COMP_7: U3.6, U13.9 (1B6)
/COMP_8: U4.7, U13.11 (1B7)
/COMP_9: U8.7, U13.22 (2B7)
/COMP_10: U8.6, U13.23 (2B8)
/COMP_11: U2.6, U13.6 (1B4)
/COMP_12: U2.7, U13.5 (1B3)
/COMP_13: U6.7, U13.16 (2B3)
/COMP_14: U5.7, U13.13 (2B1)
/COMP_15: U1.6, U13.3 (1B2)
/COMP_16: U1.7, U13.2 (1B1)
/DAC_Din: P6.22, U11.11 (Din)
/DAC_SCLK: P6.23, U11.10 (SCLK)
/DAC_~SYNC: P6.24, U11.9 (~SYNC)
/MON_5VA: P6.1, R9.1, R10.2
/OUT_1: P6.15, U13.35 (2A2)
/OUT_2: P6.19, U13.29 (2A6)
/OUT_3: P6.9, U13.41 (1A5)
/OUT_4: P6.12, U13.37 (1A8)
/OUT_5: P6.17, U13.32 (2A4)
/OUT_6: P6.18, U13.30 (2A5)
/OUT_7: P6.10, U13.40 (1A6)
/OUT_8: P6.11, U13.38 (1A7)
/OUT_9: P6.20, U13.27 (2A7)
/OUT_10: P6.21, U13.26 (2A8)
/OUT_11: P6.8, U13.43 (1A4)
/OUT_12: P6.7, U13.44 (1A3)
/OUT_13: P6.16, U13.33 (2A3)
/OUT_14: P6.14, U13.36 (2A1)
/OUT_15: P6.6, U13.46 (1A2)
/OUT_16: P6.5, U13.47 (1A1)
/TEMPS: P1.24, P6.27
/Vb_MON: P6.28, R8.1, U14.1
GND: C1.2, C2.2, C3.2, C4.2, C5.2, C6.2, C7.2, C8.2, C9.2, C10.2, C11.2, C12.2, C13.2, C14.2, C15.2, C16.2, C17.2, C20.2, C21.2, C22.2, C23.2, C24.2, C25.2, P1.1, P1.2, P1.20, P1.23, P6.13, P6.26, R10.1, U1.5, U2.5, U3.5, U4.5, U5.5, U6.5, U7.5, U8.5, U9.2 (GND), U10.3 (+), U11.6 (GND), U11.13 (A0), U11.14 (A1), U11.15 (~ENABLE), U11.16 (LDAC), U12.2 (GND), U13.1 (1DIR), U13.4 (GND), U13.10 (GND), U13.15 (GND), U13.21 (GND), U13.24 (2DIR), U13.25 (2~OE), U13.28 (GND), U13.34 (GND), U13.39 (GND), U13.45 (GND), U13.48 (1~OE), U14.2, U14.3 (+)
unnamed: C10.1, U9.4 (BYP)
unnamed: C18.1, D1.2 (K), U12.5 (D)
unnamed: C18.2, L1.2, U12.1 (SW)
unnamed: C19.1, C20.1, R4.1, R5.2, R6.2
unnamed: C19.2, R4.2, U12.3 (FB)
unnamed: D1.1 (A), R5.1
unnamed: P2.1, U11.3 (VrefH/OUT)
unnamed: P3.1, U11.8 (VoutD)
unnamed: R1.1, R2.2, U10.4 (-)
unnamed: R2.1, R3.2, U10.1
unnamed: R7.1, R8.2, U14.4 (-)
REG_EN: P6.25, U9.3 (INH), U12.4 (~SHDN)
Vbias: C14.1, P1.21, R3.1, R7.2
Vbias_SET: R1.2, U11.1 (VoutA)
Vmid: P1.19, U11.7 (VoutC)
Vneg: C21.1, P5.1, R6.1, U10.2
Vset: U1.2 (-), U1.4 (-), U2.2 (-), U2.4 (-), U3.2 (-), U3.4 (-), U4.2 (-), U4.4 (-), U5.2 (-), U5.4 (-), U6.2 (-), U6.4 (-), U7.2 (-), U7.4 (-), U8.2 (-), U8.4 (-), U11.2 (VoutB)

Notes on the sheet:
+5VA is actually 4.7V, as we regulate down to reduce noise
-34V

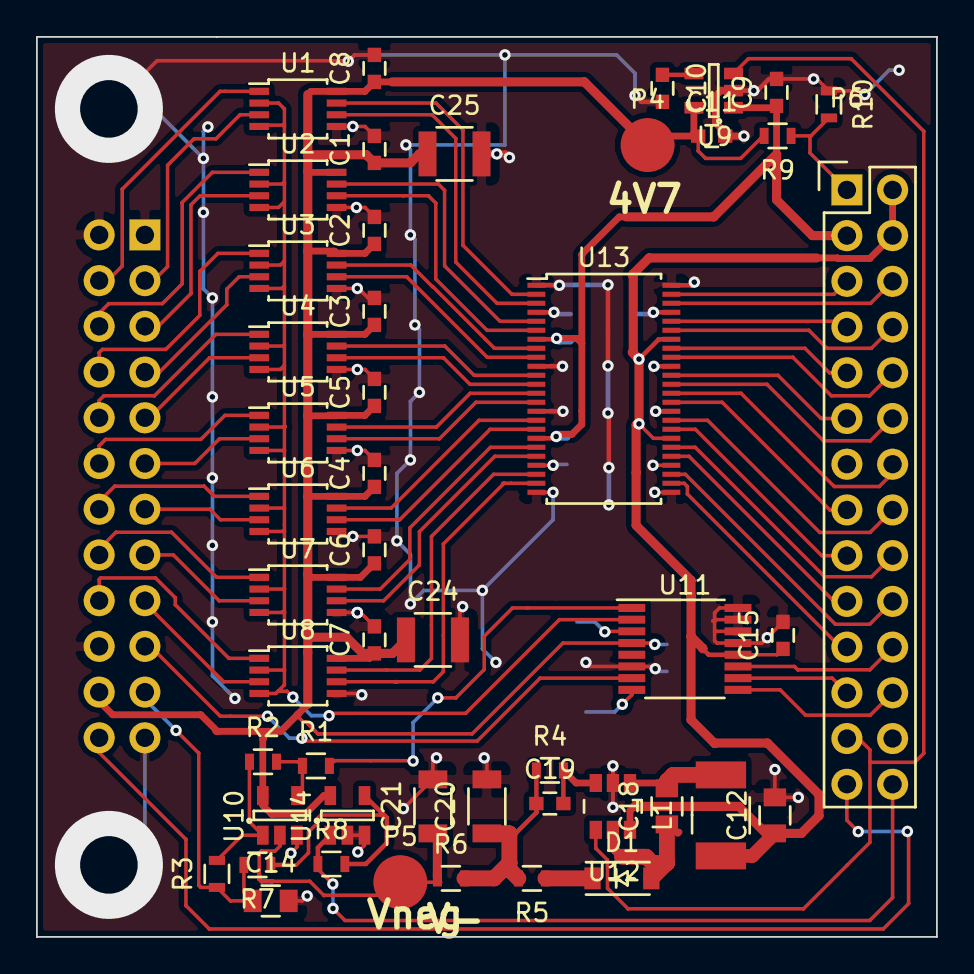
[picture p13: board sipm-comp.kicad_pcb from above]

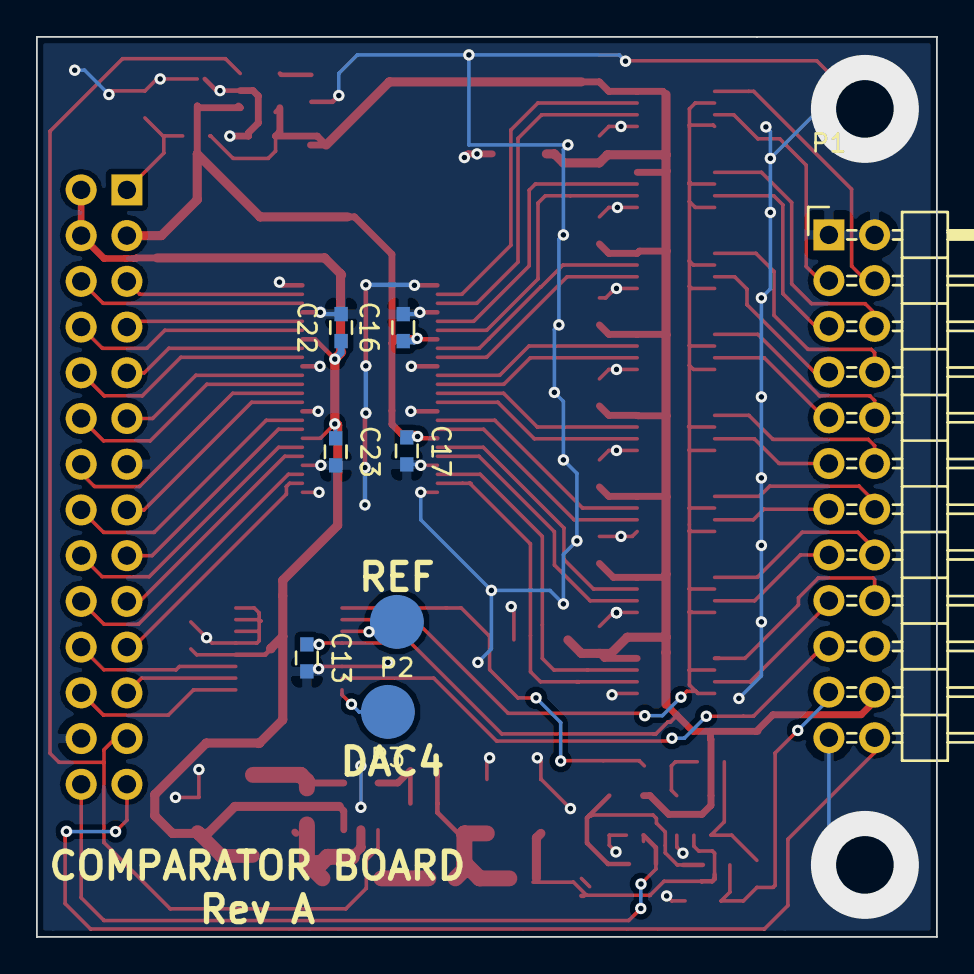
[picture p14: board sipm-comp.kicad_pcb from below]

Board: 2 copper layers, 50.0 x 50.0 mm, 57 parts (8 on the bottom side), 75 nets.
