team-impulse/Biscay_Blueeye/software/TxWorkingSDFAT/TxWorkingSDFAT.ino

#include <MinimumSerial.h>
#include <SdFat.h>
#include <SdFatConfig.h>
#include <SdFatmainpage.h>
#include <SdFatUtil.h>
#include <SdInfo.h>
#include <SdSpi.h>
#include <SdSpiCard.h>

#include <Wire.h>
#include <TinyGPS++.h>
#include <sensor_library.h>
#include <SPI.h>

//interface pins
#define fpga_sck 2
#define fpga_cs0 3
#define fpga_miso 5
#define fpga_captd 7
#define fpga_clr 14
#define fpga_cs1 16
#define dac_mosi 17
#define dac_sclk 20
#define dac_sync 21
#define reg_en 22
#define bias_mon A14
#define temp_sense A11
#define accel_interrupt 1

#include <RFM98W_library.h>
RFMLib radio =RFMLib(10,8,255,255);
#define nss 10
#define printsdline(a,b) a.print(b);a.print(",");
#define printsdline5(a,b) a.print(b,5);a.print(",");

SensLib sns;
TinyGPSPlus gps;

String hablog;

String eventlog;
#define sdnss 15


//constants 
const double vref = 2.5; 
const double vbias_scale = -15;
const double bias_mon_scale = -(500.0/15.0);
//settings
const double vbias = -31;
const double vmid = 1.65;
const double thresh = 0.025;
const int interval = 5000;
boolean sd_initialised = false;


void write_dac(uint32_t data) {
  digitalWrite(dac_sclk, LOW);
  digitalWrite(dac_sync, LOW);

  for(int32_t curbit = 23; curbit >= 0; curbit--) {
    digitalWrite(dac_sclk, HIGH);
    digitalWrite(dac_mosi, ((data & (1 << curbit)) != 0));
    delayMicroseconds(10);
    digitalWrite(dac_sclk, LOW);
    delayMicroseconds(10);
  }
  digitalWrite(dac_sync, HIGH);
}

void set_dac_channel_voltage(uint8_t channel, double voltage) {
  uint16_t rawval = 4096 * (voltage / vref);
  if(rawval >= 4096) rawval = 4095;
  Serial.print("rawval === ");
  Serial.println(rawval);
  write_dac((0x01 << 20UL) | ((channel & 0x03) << 17UL) | (rawval << 4UL));
}

double read_channel_averaging(int channel) {
  long sum = 0;
  for(int i = 0; i < 20; i++) {
    sum += analogRead(channel); 
  }
  double val = sum / 20.0;
  return (val * 3.3) / 1023;
}

double read_vbias() {
  double unscaled = read_channel_averaging(bias_mon);
  return unscaled * bias_mon_scale;
}

void read_fpga(uint8_t cspin, uint16_t *buffer, int count) {
  digitalWrite(fpga_sck, LOW);
  delayMicroseconds(2);
  digitalWrite(cspin, LOW);
  for(int curword = 0; curword < count; curword++) {
    buffer[curword] = 0;
    for(int curbit = 15; curbit >= 0; curbit--) {
      if(digitalRead(fpga_miso)==1) {
        buffer[curword] |= (1 << curbit);
      }
      digitalWrite(fpga_sck, HIGH);
      delayMicroseconds(2);

      digitalWrite(fpga_sck, LOW);
      delayMicroseconds(2);
    }
  }
  digitalWrite(cspin, HIGH); 
}

//============================================================
const byte threshold = 100;
const long transmit_period = 5000;
uint64_t timer;
uint16_t counts[2];//total counts, counts above threshold

SdFat sd;


//============================================================
void setup(){
  pinMode(13,OUTPUT);
  pinMode(sdnss,OUTPUT);
  digitalWrite(sdnss, HIGH);
  pinMode(10,OUTPUT);
  digitalWrite(10,HIGH);
  Serial1.begin(9600);//GPS serial...eventually
  setGPS_DynamicModel6();
  Wire.begin();
    SPI.begin();
  sns.initialise();//initialise sensors
  
    byte my_config[5] = {
    0x54,0x94,0xFA,0xAC,0xCD  };//radio settings
  radio.configure(my_config);


/*  if(!SD.begin(sdnss)){
   Serial.println("SD initialisation failed"); 
  } else Serial.println("SD card initialisation success!");*/
  
  if (!sd.begin(sdnss, SPI_HALF_SPEED)) {
    //sd.initErrorHalt();
    Serial.println("SD initialisation failed"); 
  }
  else{
   sd_initialised = true; 
  }




  hablog = genNewLogFileName("HAB_","GPS time, millis time, lat,long, hdop, pressure, temperature, total event count, thresholded event count");
  eventlog = genNewLogFileName("EV_","test");

  Serial.begin(38400);


  Serial.println("config2");
  pinMode(reg_en, OUTPUT);
  digitalWrite(reg_en, LOW);
  pinMode(dac_sync, OUTPUT);
  digitalWrite(dac_sync, HIGH);
  pinMode(dac_sclk, OUTPUT);
  pinMode(dac_mosi, OUTPUT);

  pinMode(fpga_sck, OUTPUT);
  pinMode(fpga_cs0, OUTPUT);
  digitalWrite(fpga_cs0, HIGH);
  pinMode(fpga_miso, INPUT);
  pinMode(fpga_cs1, OUTPUT);
  digitalWrite(fpga_cs1, HIGH);

  pinMode(fpga_clr, OUTPUT);
  digitalWrite(fpga_clr, HIGH);
  delay(1);
  Serial.println("config3");


  pinMode(fpga_captd, INPUT);
  Serial.println("Turning on supplies");
  digitalWrite(reg_en, HIGH);
  Serial.print("Setting bias to ");
  Serial.print(vbias);
  Serial.println("V");
  set_dac_channel_voltage(0, vbias / vbias_scale);
  Serial.print("Setting midpoint to ");
  Serial.print(vmid);
  Serial.println("V");
  set_dac_channel_voltage(2, vmid);
  Serial.print("Setting threshold voltage to ");
  Serial.print(vmid-thresh);
  Serial.println("V");
  set_dac_channel_voltage(1, vmid-thresh);
  set_dac_channel_voltage(0, vbias / vbias_scale);

  Serial.println("config4");
  Serial.println("Please wait for Vbias to stabilise.");
  delay(2000);
  double biasVal = read_vbias();
  Serial.print("Vbias=");
  Serial.println(biasVal);
  digitalWrite(fpga_clr, LOW);
  //   radio.rfm_done = true;
  Serial.println("config5");
  timer = millis();
}
uint32_t lastchars = 0;
void loop(){
  
  while(Serial1.available())gps.encode(Serial1.read());//feed tinyGPS++ object  
  if((millis()-timer)>transmit_period){
    send_data();
    //sd logging
    char lognamechar[hablog.length()];
    hablog.toCharArray(lognamechar, hablog.length());
    File hablogf = sd.open( lognamechar,FILE_WRITE);
    // GPS time, millis time, lat,long, hdop, pressure, temperature, total event count, thresholded event count
    printsdline(hablogf,gps.time.value())
    printsdline(hablogf,millis())
    printsdline5(hablogf,gps.location.lat())
    printsdline5(hablogf,gps.location.lng())
    printsdline(hablogf,gps.hdop.value())
    printsdline(hablogf,sns.pressure)
    printsdline(hablogf,sns.internal_temperature)
    printsdline(hablogf,counts[0])
    hablogf.println(counts[1]);
    hablogf.close();    
    
    timer = millis();
    counts[0]=0;
    counts[1]=0;
    lastchars = gps.charsProcessed();
  }
  if(digitalRead(fpga_captd)==1) {
    Serial.println("EVENT!!!");
    uint16_t data[17];
    read_fpga(fpga_cs0, data, 17);
    if(reverse_bits(data[16])>=threshold)
      counts[1]++;
    counts[0]++;
    log_event(data);
    /*Serial.print("===");
     for(int i = 0; i < 17; i++) {
     Serial.print(reverse_bits(data[i]));
     if(i!=16) Serial.print(","); 
     }*/


    //Serial.println();
    //rf print reverse_bits(data[16])
    /*   if(radio.rfm_status==0){//if radio idle
     uint16_t rfprint = reverse_bits(data[16]);
     RFMLib::Packet p;
     p.data[0] = (rfprint>>8)&0xFF;
     p.data[1] = (rfprint)&0xFF;
     p.data[2] = (rejected>>8)&0xFF;
     p.data[3] = rejected & 0xFF;
     p.len = 4;
     rejected = 0;
     radio.beginTX(p);
     
     
     attachInterrupt(8,RFMISR, RISING);
     }
     else rejected++;


  /*  digitalWrite(13,LOW);
    delay(200);
    digitalWrite(13,HIGH);
    delay(200);
    digitalWrite(13,LOW);*/

    digitalWrite(fpga_clr, HIGH);
    delayMicroseconds(10);
    digitalWrite(fpga_clr, LOW);
  }


  if(radio.rfm_done){
    Serial.println("Ending");   
    radio.endTX();
  }

}

void send_data(){
  RFMLib::Packet p;
  sns.pollMS5637();
  p.data[0] = sns.pressure>>24;
  p.data[1] = (sns.pressure >> 16) & 0xFF;
  p.data[2] = (sns.pressure>>8) & 0xFF;
  p.data[3] = sns.pressure & 0xFF;
  byte temp = (byte)((int)((sns.internal_temperature/100)+0.5)+(int)128);
  p.data[4] = temp;
  p.data[5] = (counts[0]<<8)&0xFF;
  p.data[6] = (counts[0]&0xFF);
  p.data[7] = (counts[1]<<8)&0xFF;
  p.data[8] = (counts[1]&0xFF);
  double posn_mod = gps.location.lat() - 50;
  uint32_t posn = (uint32_t)(abs(posn_mod) * 10000);
  p.data[9] = (posn>>24)&0xFF;
  p.data[10] = (posn>>16)&0xFF;
  p.data[11] = (posn>>8)&0xFF;
  p.data[12] = posn &0xFF;
  posn_mod = gps.location.lng();
  posn = (uint32_t)(abs(posn_mod) * 10000);
  p.data[13] = (posn>>24)&0xFF;
  p.data[14] = (posn>>16)&0xFF;
  p.data[15] = (posn>>8)&0xFF;
  p.data[16] = posn &0xFF;
  
  byte sys_status=0;
  if(sd_initialised) sys_status = sys_status | (1);
  if(gps.hdop.value()<400) sys_status = sys_status | (1<<1);
  if(gps.satellites.value()>=3) sys_status = sys_status | (1<<2);
  if(gps.charsProcessed() > lastchars)sys_status = sys_status | (1<<3);
  p.data[17] = sys_status;
  
  
  
  
  p.len = 18;
  radio.beginTX(p);
  Serial.println("begin");

  attachInterrupt(8,RFMISR, RISING);
}

void RFMISR(){
  Serial.println("interrupt");
  radio.rfm_done = true; 
}


uint16_t reverse_bits(uint16_t in) {
  uint16_t result = 0;
  for(int cbit = 0; cbit < 16; cbit++) {
    if((in & (1<<cbit)) != 0) {
      result |= (1 << (15 - cbit)); 
    }
  } 
  return result;
}

String genNewLogFileName(String base,String header){
  File lf;
  String ln;
   int16_t logcnt = 0;
   
  while(true){
    ln = base;
   ln = ln + "LOG";
   ln = ln + logcnt;
   ln = ln + ".csv";
   char lognamechar[ln.length()];
   ln.toCharArray(lognamechar, ln.length());
   lf = sd.open(lognamechar);
   if(!lf){
     Serial.println("Generated logfile name:");
     Serial.println(ln);
     break;
   }
   lf.close();
   
   logcnt++;
  }//generate a file name that doesn't overwrite anything
  char lognamechar[ln.length()];
  ln.toCharArray(lognamechar, ln.length());
  File f = sd.open( lognamechar,FILE_WRITE);
  f.println(header);
  f.close();
  return ln;
}

void log_event(uint16_t edata[]){
  //GPS time, millis, lat, long, hdop, pressure, temp, data[0],data[1],data[2],data[3],data[4],data[5],data[6],data[7],data[8],data[9],data[10],data[11],data[12],data[13],data[14],data[15],data[16]
   char lognamechar[eventlog.length()];
    eventlog.toCharArray(lognamechar, eventlog.length());
    File elog = sd.open( lognamechar,FILE_WRITE);
    // GPS time, millis time, lat,long, hdop, pressure, temperature, total event count, thresholded event count
    printsdline(elog,millis())
    for(int i =0;i<16;i++){
      printsdline(elog,reverse_bits(edata[i]))
    }
    elog.println(reverse_bits(edata[16]));
    elog.close();    
}



//---gps reconfig courtesy of CUSF/Anthony Stirk
//========================================
void setGPS_DynamicModel6()
{
 int gps_set_sucess=0;
 uint8_t setdm6[] = {
 0xB5, 0x62, 0x06, 0x24, 0x24, 0x00, 0xFF, 0xFF, 0x06,
 0x03, 0x00, 0x00, 0x00, 0x00, 0x10, 0x27, 0x00, 0x00,
 0x05, 0x00, 0xFA, 0x00, 0xFA, 0x00, 0x64, 0x00, 0x2C,
 0x01, 0x00, 0x00, 0x00, 0x00, 0x00, 0x00, 0x00, 0x00,
 0x00, 0x00, 0x00, 0x00, 0x00, 0x00, 0x16, 0xDC };
 byte x=0;
 while(!gps_set_sucess && x<5)
 {
 sendUBX(setdm6, sizeof(setdm6)/sizeof(uint8_t));
 gps_set_sucess=getUBX_ACK(setdm6);

 x++;
 }
}
void sendUBX(uint8_t *MSG, uint8_t len) {
 Serial1.flush();
 Serial1.write(0xFF);
delay(500);
 for(int i=0; i<len; i++) {
 Serial1.write(MSG[i]);
 }
}
boolean getUBX_ACK(uint8_t *MSG) {
 uint8_t b;
 uint8_t ackByteID = 0;
 uint8_t ackPacket[10];
 unsigned long startTime = millis();
 
// Construct the expected ACK packet
 ackPacket[0] = 0xB5; // header
 ackPacket[1] = 0x62; // header
 ackPacket[2] = 0x05; // class
 ackPacket[3] = 0x01; // id
 ackPacket[4] = 0x02; // length
 ackPacket[5] = 0x00;
 ackPacket[6] = MSG[2]; // ACK class
 ackPacket[7] = MSG[3]; // ACK id
 ackPacket[8] = 0; // CK_A
 ackPacket[9] = 0; // CK_B
 
// Calculate the checksums
 for (uint8_t ubxi=2; ubxi<8; ubxi++) {
 ackPacket[8] = ackPacket[8] + ackPacket[ubxi];
 ackPacket[9] = ackPacket[9] + ackPacket[8];
 }
 
while (1) {
 
// Test for success
 if (ackByteID > 9) {
 // All packets in order!
 return true;
 }
 
// Timeout if no valid response in 3 seconds
 if (millis() - startTime > 3000) {
 return false;
 }
 
// Make sure data is available to read
 if (Serial1.available()) {
 b = Serial1.read();
 
// Check that bytes arrive in sequence as per expected ACK packet
 if (b == ackPacket[ackByteID]) {
 ackByteID++;
 }
 else {
 ackByteID = 0; // Reset and look again, invalid order
 }
 }
 }
}
