team-impulse/Biscay_Blueeye/(commit log)

2015-10-05 Added current hardware designs
    Are broken in places, do not build or order
    [Amp.sch, mcu.kicad_pcb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]
2015-10-05 Got rid of Base subproject and added dedicated base GUI folder
    [RAW_DATA0.CSV, RAW_DATA1.CSV, RAW_DATA10.CSV, RAW_DATA11.CSV, RAW_DATA12.CSV, RAW_DATA13.CSV, RAW_DATA14.CSV, RAW_DATA15.CSV]
2015-10-25 Began packet schema. Continued debugging firmware.
    [Packet Schema.xlsx]
2015-10-25 Rewrote transmission code (now in TxWorking). GPS and LoRa stuff working. Rx End developed.
    [Packet Schema.xlsx]
2015-11-03 Changed radio settings. Console changes. Sample log.
